eric-handley/a3-srad-camera-kicad/kicad/camera.step

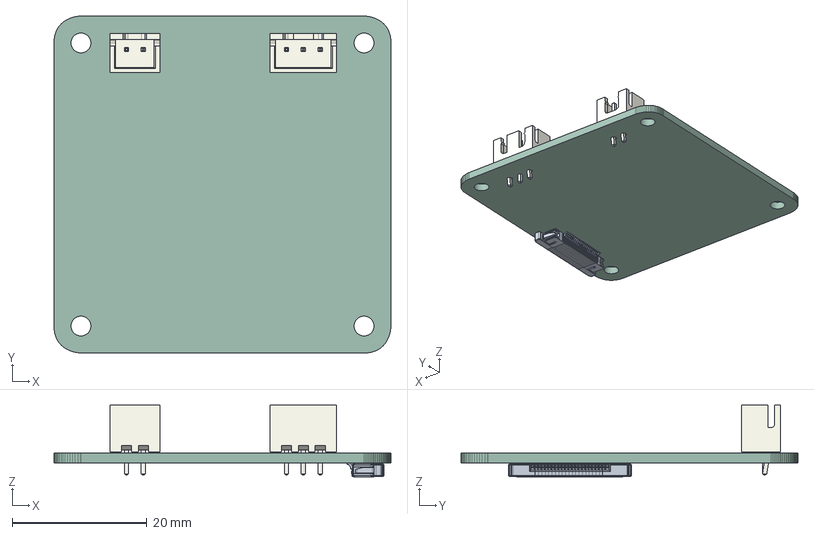
[picture p1: CAD file, 2026-01-13]
kicad/camera.step
50.0 x 50.0 x 10.7 mm
JST_XH_B2B-XH-A_1x02_P2.50mm_Vertical
JST_XH_B3B-XH-A_1x03_P2.50mm_Vertical
F32R_R
F32R_M x 20
F32R_L
srad-camera_PCB
