eric-handley/a3-srad-camera-kicad/kicad/srad-camera-models/RK3566--3DModel-STEP-56544.STEP

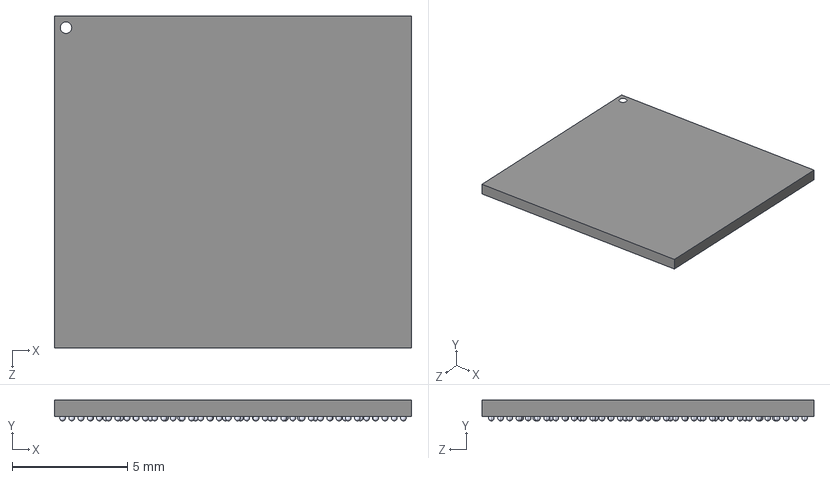
[picture p2: CAD file, 2026-01-15]
kicad/srad-camera-models/RK3566--3DModel-STEP-56544.STEP
15.5 x 0.904 x 14.4 mm
Body^RK3566
ball^RK3566 x 564
