eric-handley/a3-srad-camera-kicad/kicad/srad-camera-models/MT41K256M16TW-107-P--3DModel-STEP-56544.STEP

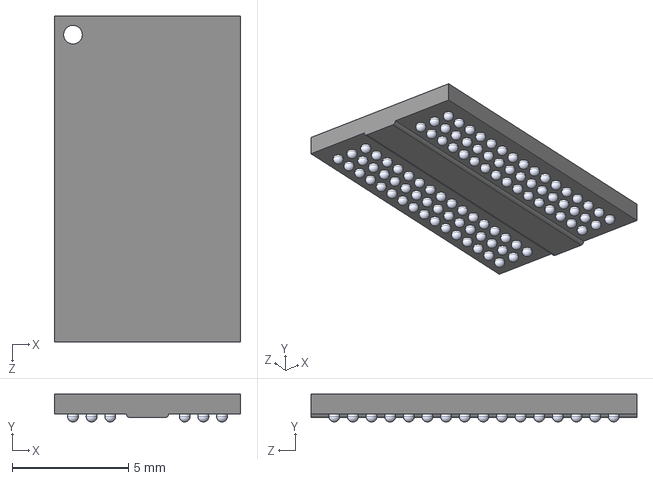
[picture p3: CAD file, 2026-01-15]
kicad/srad-camera-models/MT41K256M16TW-107-P--3DModel-STEP-56544.STEP
8.00 x 1.20 x 14.0 mm
