eric-handley/a3-srad-camera-kicad/kicad/srad-camera-models/0472192001.stp

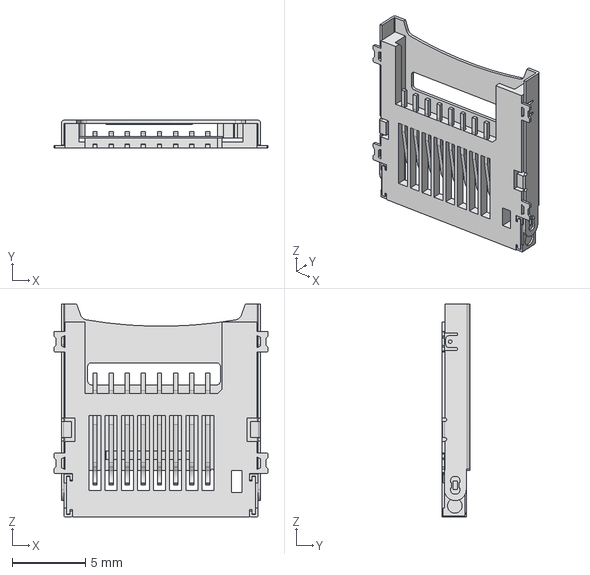
[picture p4: CAD file, 2026-01-15]
kicad/srad-camera-models/0472192001.stp
14.6 x 1.90 x 14.5 mm
