eric-handley/a3-srad-camera-kicad/kicad/srad-camera-models/12402012E212A--3DModel-STEP-533217.STEP

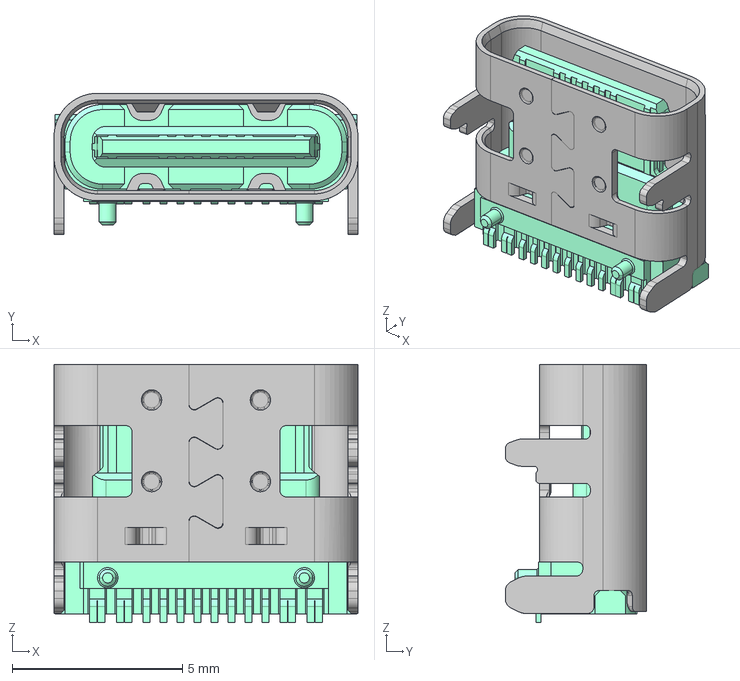
[picture p5: CAD file, 2026-01-15]
kicad/srad-camera-models/12402012E212A--3DModel-STEP-533217.STEP
8.94 x 4.16 x 7.60 mm
