eric-handley/a3-srad-camera-kicad/kicad/srad-camera-models/10051922-2210ELF--3DModel-STEP-533217.STEP

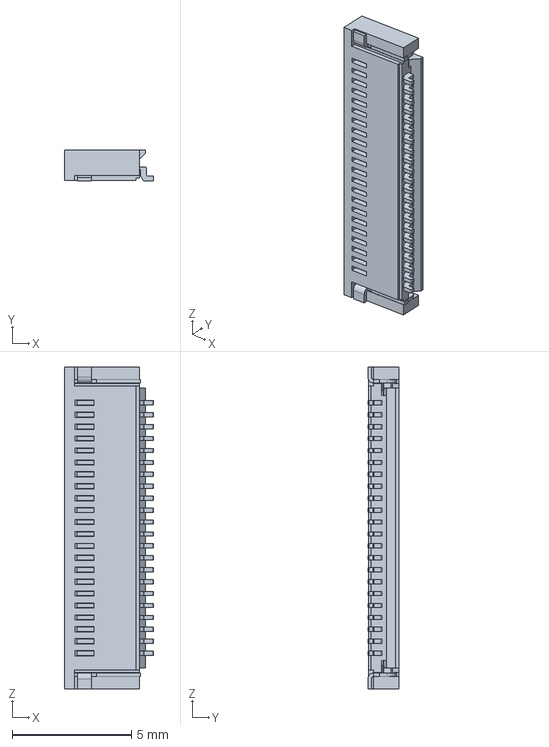
[picture p6: CAD file, 2026-01-15]
kicad/srad-camera-models/10051922-2210ELF--3DModel-STEP-533217.STEP
3.75 x 1.30 x 13.5 mm
