eric-handley/a3-srad-camera-kicad/reference/[rs107]zero 3w_v1.11_20230921 - DDR PHY+wiring.pdf

# RK3566_F(DDR PHY)

## DDR4

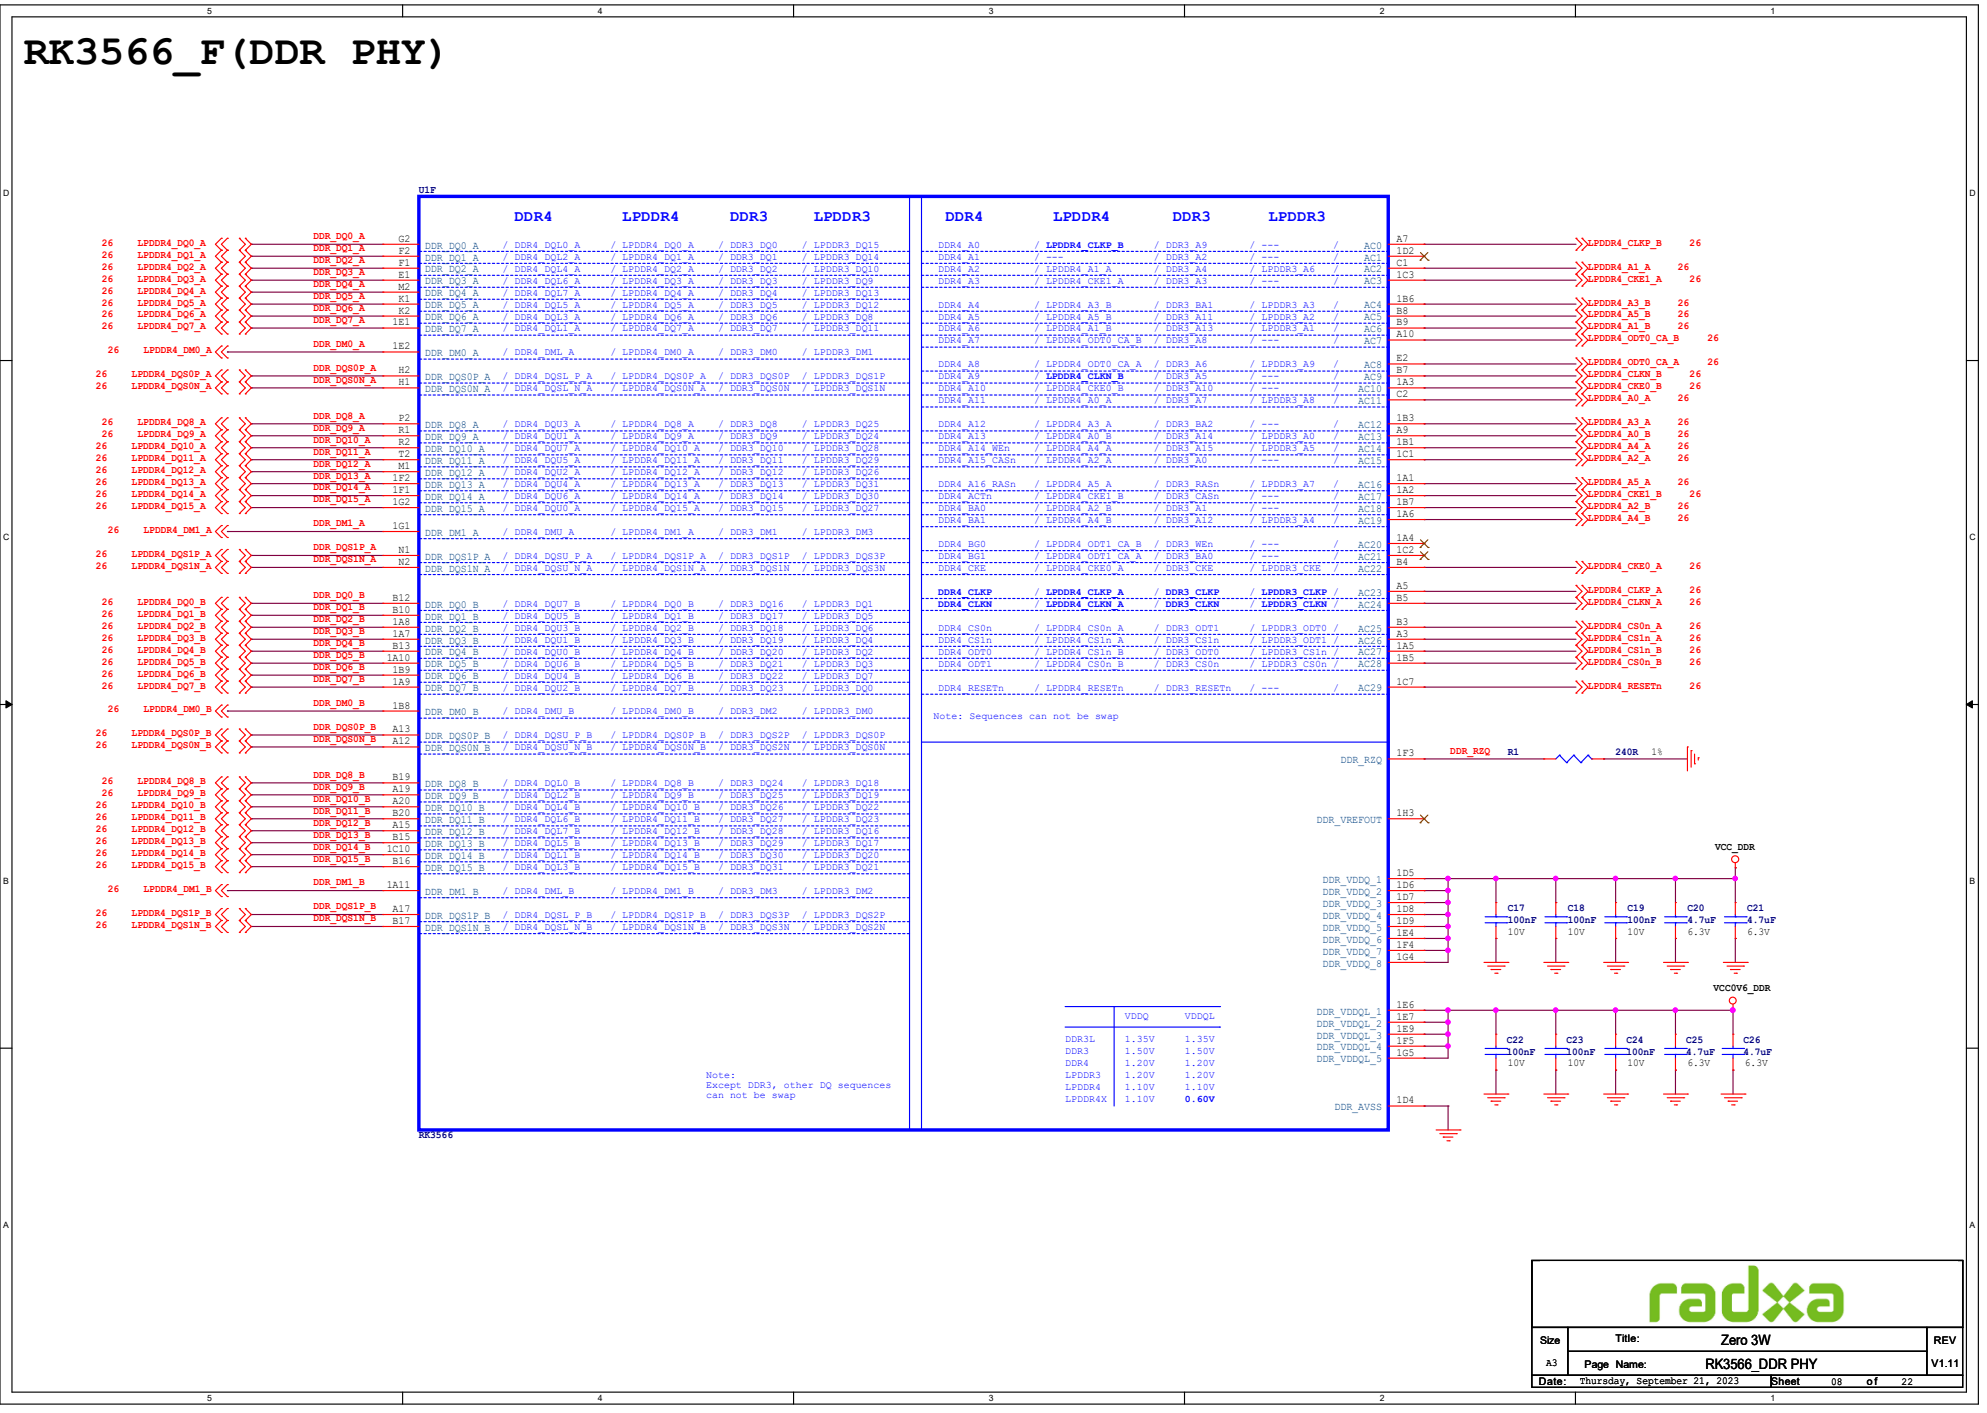
[picture p22: page 1]

Note: Sequences can not be swap

Note:
Except DDR3, other DQ sequences
can not be swap

# CH BCH A

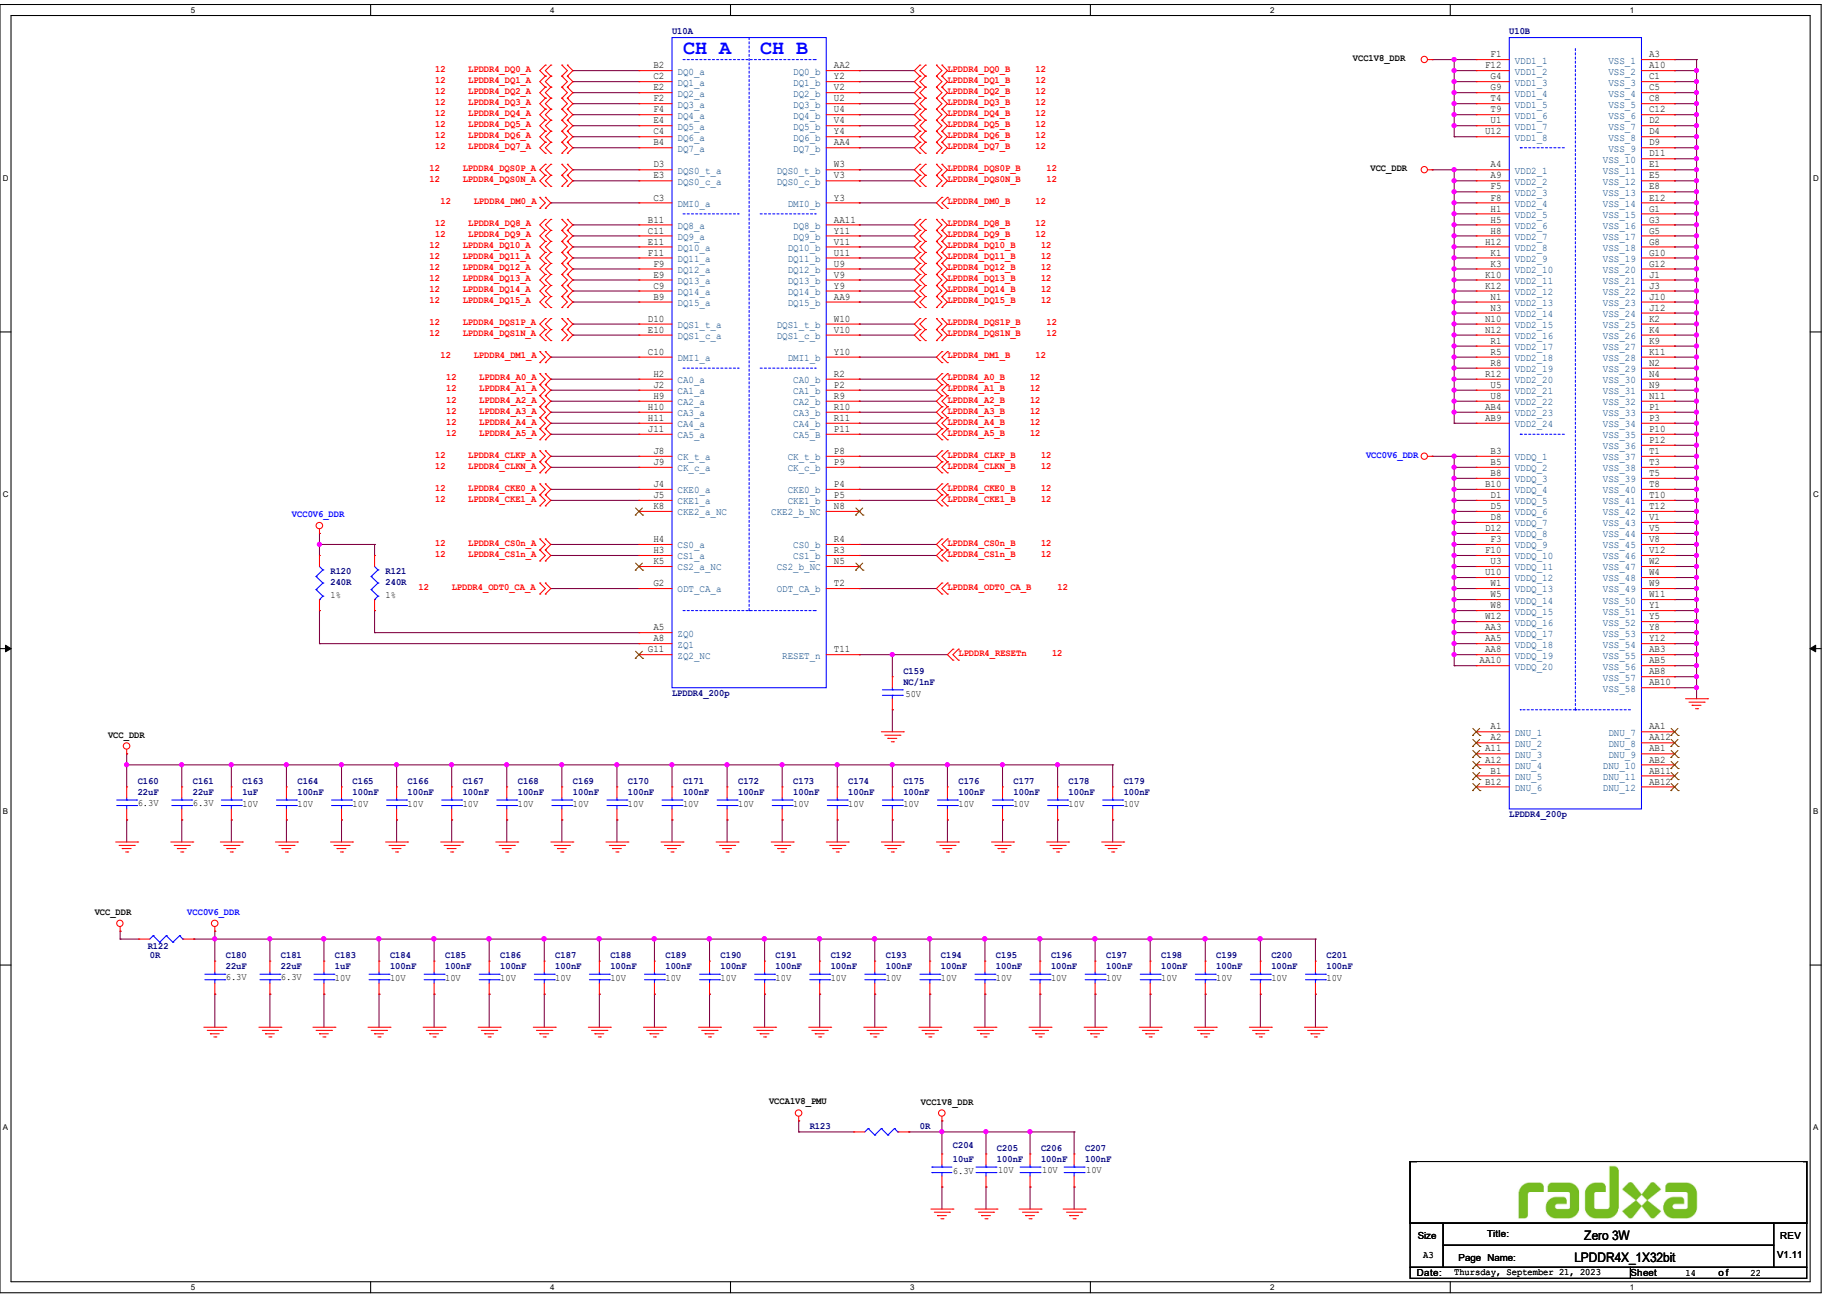
[picture p23: page 2]
