eric-handley/a3-srad-camera-kicad/kicad/srad-camera.kicad_pcb

## KiCad design kicad/srad-camera.kicad_pcb (2026-01-18)

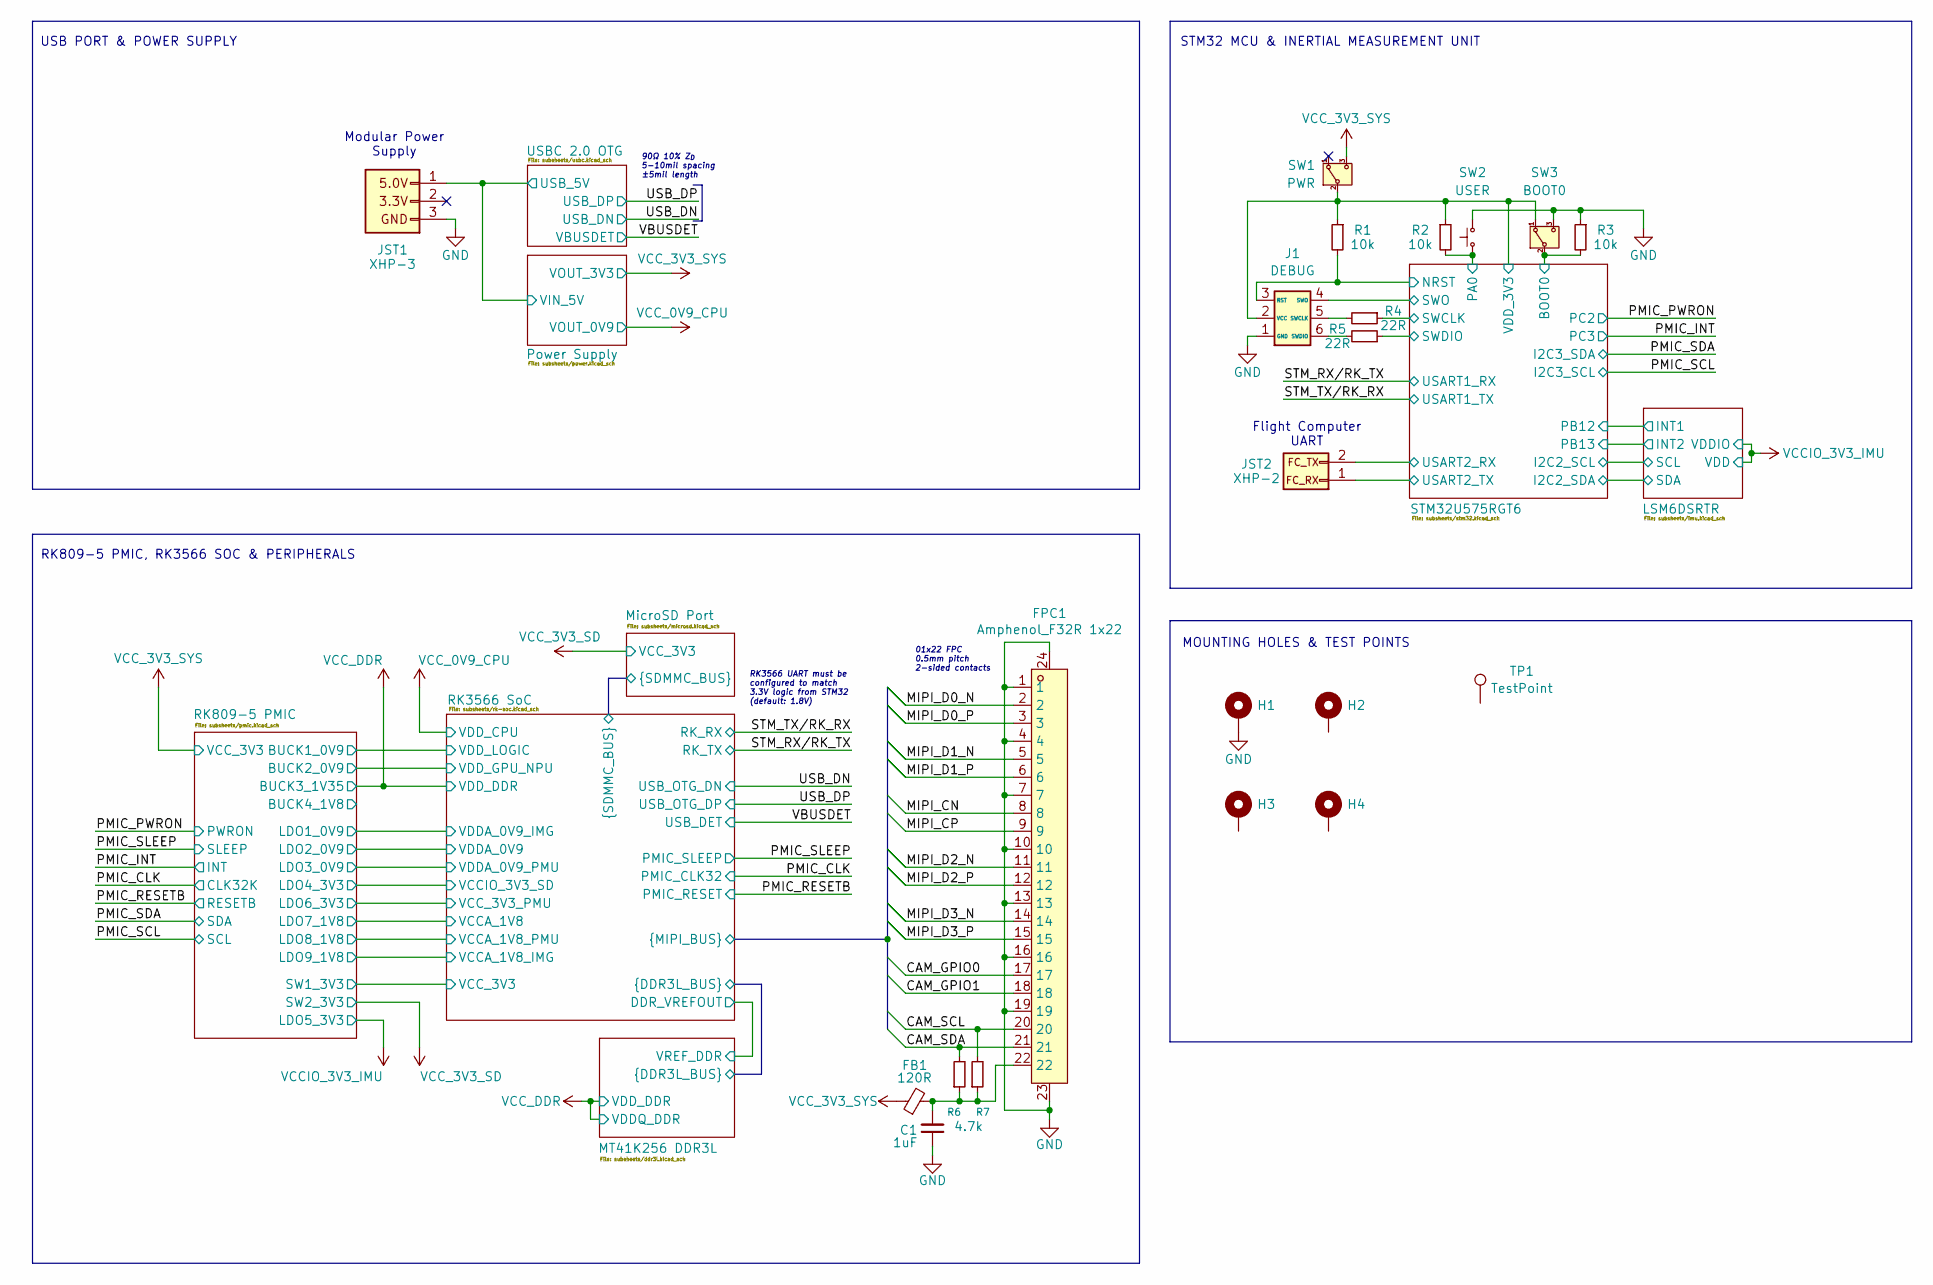
[picture p24: schematic srad-camera.kicad_sch, SRAD Camera]

Parts:
C1: 1uF; C_0603_1608Metric; LCSC PART NAME C15849
FB1: 120R; R_0201_0603Metric; LCSC PART NAME C14709
FPC1: Amphenol_F32R 1x22; AMPHENOL_10051922-2210ELF; MANUFACTURER PART 0.5K-AX-22PWB; JLCPCB PART CLASS Extended Part
H1, H2, H3, H4: MntHole; 4-40_MountingHole
J1: DEBUG; PinHeader_2x03_P1.27mm_Vertical
JST1: XHP-3; JST_XH_B3B-XH-A_1x03_P2.50mm_Vertical
JST2: XHP-2; JST_XH_B2B-XH-A_1x02_P2.50mm_Vertical
R1, R2, R3: 10k; R_0402_1005Metric; LCSC PART NAME C25744
R4, R5: 22R; R_0402_1005Metric; LCSC PART NAME C25092
R6, R7: 4.7k; R_0402_1005Metric; LCSC PART NAME C25900
SW1: PWR; SW_SPDT_PCM12
SW2: USER; SW_SPST_EVQP2_MiddlePushTravel_H2.5mm
SW3: BOOT0; SW_SPDT_PCM12
TP1: TestPoint

Connections:
/Power Supply/VIN_5V: JST1.1; also elsewhere on the board
/RK3566 SoC/CAM_GPIO0: FPC1.17; also elsewhere on the board
/RK3566 SoC/CAM_GPIO1: FPC1.18; also elsewhere on the board
/RK3566 SoC/CAM_SCL: FPC1.20, R7.2; also elsewhere on the board
/RK3566 SoC/CAM_SDA: FPC1.21, R6.2; also elsewhere on the board
/RK3566 SoC/MIPI_CN: FPC1.8; also elsewhere on the board
/RK3566 SoC/MIPI_CP: FPC1.9; also elsewhere on the board
/RK3566 SoC/MIPI_D0_N: FPC1.2; also elsewhere on the board
/RK3566 SoC/MIPI_D0_P: FPC1.3; also elsewhere on the board
/RK3566 SoC/MIPI_D1_N: FPC1.5; also elsewhere on the board
/RK3566 SoC/MIPI_D1_P: FPC1.6; also elsewhere on the board
/RK3566 SoC/MIPI_D2_N: FPC1.11; also elsewhere on the board
/RK3566 SoC/MIPI_D2_P: FPC1.12; also elsewhere on the board
/RK3566 SoC/MIPI_D3_N: FPC1.14; also elsewhere on the board
/RK3566 SoC/MIPI_D3_P: FPC1.15; also elsewhere on the board
/STM32U575RGT6/BOOT0: R3.2, SW3.2 (B); also elsewhere on the board
/STM32U575RGT6/NRST: J1.3 (RST), R1.2; also elsewhere on the board
/STM32U575RGT6/PA0: R2.2, SW2.1; also elsewhere on the board
/STM32U575RGT6/SWCLK: R4.1; also elsewhere on the board
/STM32U575RGT6/SWDIO: R5.1; also elsewhere on the board
/STM32U575RGT6/SWO: J1.4 (SWO); also elsewhere on the board
/STM32U575RGT6/USART2_RX: JST2.2; also elsewhere on the board
/STM32U575RGT6/USART2_TX: JST2.1; also elsewhere on the board
/STM32U575RGT6/VDD_3V3: J1.2 (VCC), R1.1, R2.1, SW1.2 (B), SW3.1 (A); also elsewhere on the board
GND: C1.1, FPC1.1, FPC1.4, FPC1.7, FPC1.10, FPC1.13, FPC1.16, FPC1.19, FPC1.23, FPC1.24, H1.1 (MP), J1.1 (GND), JST1.3, R3.1, SW2.2, SW3.3 (C); also elsewhere on the board
unnamed: C1.2, FB1.2, FPC1.22, R6.1, R7.1
unnamed: J1.5 (SWCLK), R4.2
unnamed: J1.6 (SWDIO), R5.2
VCC_3V3_SYS: FB1.1, SW1.3 (C); also elsewhere on the board

Notes on the sheet:
STM32 MCU & INERTIAL MEASUREMENT UNIT
USB PORT & POWER SUPPLY
01x22 FPC 0.5mm pitch 2-sided contacts
90Ω 10% Z_{D} 5-10mil spacing ±5mil length
RK3566 UART must be configured to match 3.3V logic from STM32 (default: 1.8V)
RK809-5 PMIC, RK3566 SOC & PERIPHERALS
Modular Power Supply
Flight Computer UART
MOUNTING HOLES & TEST POINTS

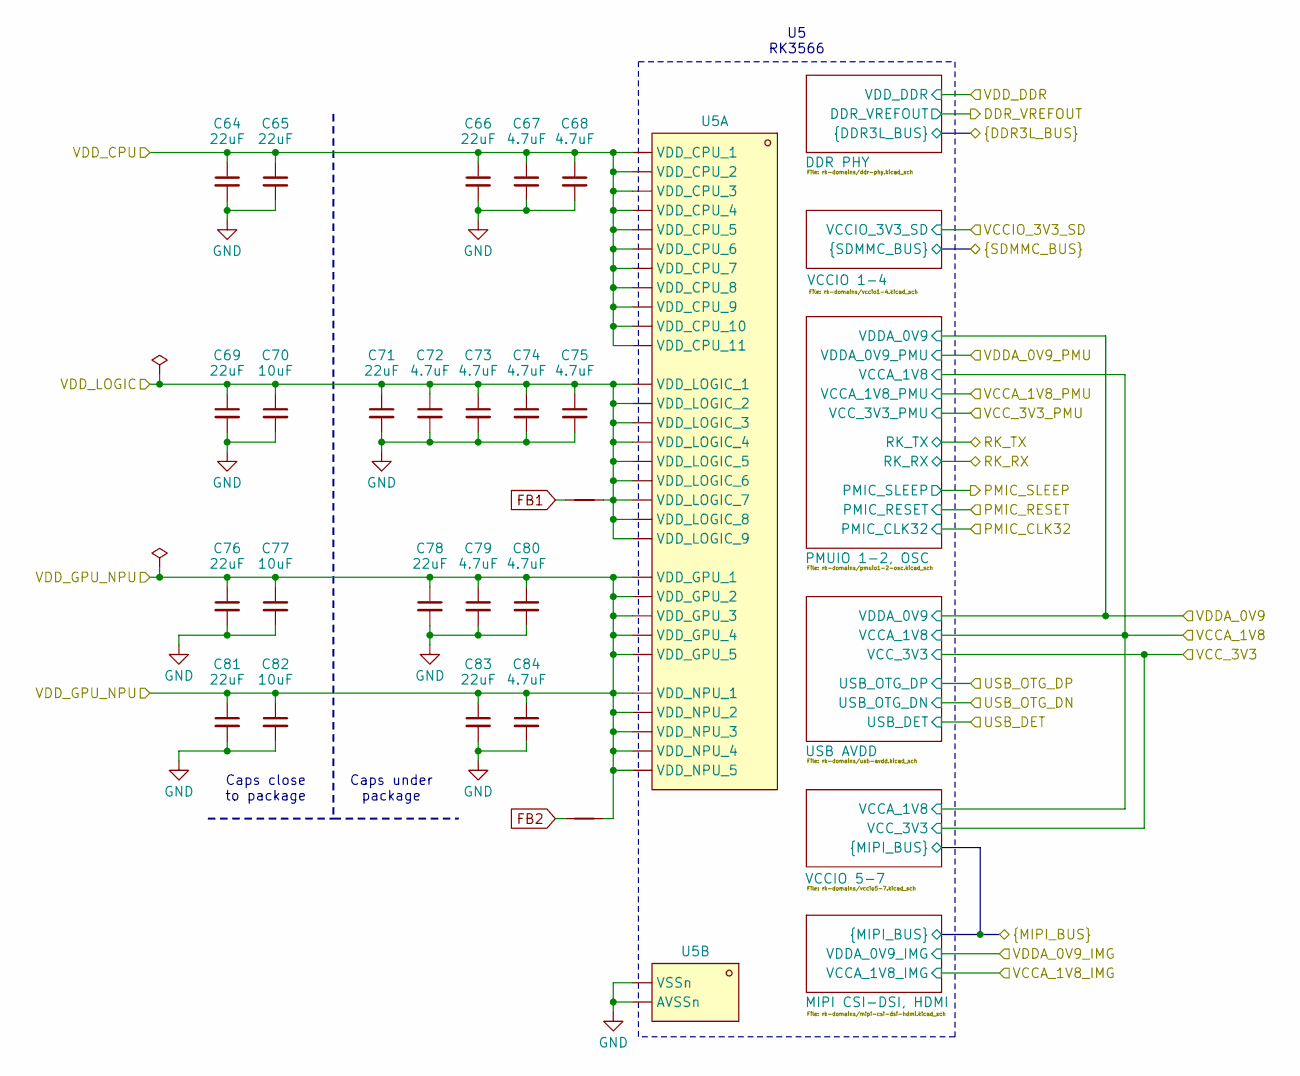
[picture p25: schematic rk-soc.kicad_sch, RK3566 SoC]

Parts:
C64, C65, C66, C69, C71, C76, C78, C81, C83: 22uF; C_1206_3216Metric; LCSC PART NAME C12891
C67, C68, C72, C73, C74, C75, C79, C80, C84: 4.7uF; C_0402_1005Metric; LCSC PART NAME C1779
C70, C77, C82: 10uF; C_0805_2012Metric; LCSC PART NAME C15850
NT3, NT4: NetTie_2
U5: RK3566; BGA-565_L15.5-W14.4-P0.40_RK3566_1; MANUFACTURER PART RK3566; JLCPCB PART CLASS Extended Part

Connections:
/RK3566 SoC/VDD_GPU_NPU: C76.1, C77.1, C78.1, C79.1, C80.1, C81.1, C82.1, C83.1, C84.1, NT4.2, U5.1G15 (VDD_NPU_1), U5.1H14 (VDD_NPU_2), U5.1H15 (VDD_NPU_3), U5.1J14 (VDD_NPU_4), U5.1J15 (VDD_NPU_5), U5.1L8 (VDD_GPU_1), U5.1L9 (VDD_GPU_2), U5.1M7 (VDD_GPU_3), U5.1M8 (VDD_GPU_4), U5.1M9 (VDD_GPU_5); also elsewhere on the board
/RK3566 SoC/VDD_LOGIC: C69.1, C70.1, C71.1, C72.1, C73.1, C74.1, C75.1, NT3.2, U5.1H7 (VDD_LOGIC_1), U5.1H8 (VDD_LOGIC_2), U5.1H9 (VDD_LOGIC_3), U5.1H10 (VDD_LOGIC_4), U5.1J7 (VDD_LOGIC_5), U5.1J10 (VDD_LOGIC_6), U5.1K7 (VDD_LOGIC_7), U5.1K10 (VDD_LOGIC_8), U5.1L7 (VDD_LOGIC_9); also elsewhere on the board
GND: C64.2, C65.2, C66.2, C67.2, C68.2, C69.2, C70.2, C71.2, C72.2, C73.2, C74.2, C75.2, C76.2, C77.2, C78.2, C79.2, C80.2, C81.2, C82.2, C83.2, C84.2, U5.1B10 (VSS_30), U5.1B11 (VSS_31), U5.1B15 (VSS_32), U5.1B19 (VSS_33), U5.1C4 (VSS_34), U5.1C5 (VSS_35), U5.1C6 (VSS_36), U5.1C8 (VSS_37), U5.1C9 (VSS_38), U5.1C14 (VSS_39), U5.1C16 (VSS_40), U5.1C18 (VSS_41), U5.1D1 (VSS_42), U5.1D3 (VSS_43), U5.1D10 (VSS_44), U5.1D14 (VSS_45), U5.1E3 (VSS_46), U5.1E8 (VSS_47), U5.1E10 (VSS_48), U5.1E14 (VSS_49), U5.1E15 (VSS_50), U5.1E17 (VSS_51), U5.1F6 (VSS_52), U5.1F7 (VSS_53), U5.1F8 (VSS_54), U5.1F9 (VSS_55), U5.1F10 (VSS_56), U5.1F15 (VSS_57), U5.1F16 (VSS_58), U5.1F20 (AVSS1_6), U5.1G3 (VSS_59), U5.1G6 (VSS_60), U5.1G7 (VSS_61), U5.1G8 (VSS_62), U5.1G9 (VSS_63), U5.1G10 (VSS_64), U5.1G11 (VSS_65), U5.1G12 (VSS_66), U5.1G14 (VSS_67), U5.1G16 (AVSS1_7), U5.1G18 (AVSS1_8), U5.1G19 (AVSS1_9), U5.1G20 (AVSS1_10), U5.1H1 (VSS_68), U5.1H2 (VSS_69), U5.1H6 (VSS_70), U5.1H11 (VSS_71), U5.1H12 (VSS_72), U5.1H13 (VSS_73), U5.1J1 (VSS_74), U5.1J6 (VSS_75), U5.1J8 (VSS_76), U5.1J9 (VSS_77), U5.1J11 (VSS_78), U5.1J12 (VSS_79), U5.1J13 (VSS_80), U5.1J16 (AVSS1_11), U5.1J18 (AVSS1_12), U5.1K2 (VSS_81), U5.1K3 (VSS_82), U5.1K4 (VSS_83), U5.1K5 (VSS_84), U5.1K6 (VSS_85), U5.1K8 (VSS_86), U5.1K9 (VSS_87), U5.1K11 (VSS_88), U5.1K12 (VSS_89), U5.1K13 (VSS_90), U5.1K14 (VSS_91), U5.1K15 (VSS_92), U5.1K18 (AVSS1_13), U5.1L3 (VSS_93), U5.1L6 (VSS_94), U5.1L10 (VSS_95), U5.1L11 (VSS_96), U5.1L12 (VSS_97), U5.1L13 (VSS_98), U5.1L14 (VSS_99), U5.1L15 (VSS_100), U5.1L19 (AVSS1_14), U5.1M3 (VSS_101), U5.1M4 (VSS_102), U5.1M5 (VSS_103), U5.1M6 (VSS_104), U5.1M10 (VSS_105), U5.1M11 (VSS_106), U5.1M12 (VSS_107), U5.1M13 (VSS_108), U5.1M14 (VSS_109), U5.1M15 (VSS_110), U5.1M16 (VSS_111), U5.1M17 (VSS_112), U5.1M20 (VSS_113), U5.1N3 (VSS_114), U5.1N4 (VSS_115), U5.1N7 (VSS_116), U5.1N11 (AVSS_9), U5.1N12 (AVSS_10), U5.1P1 (VSS_117), U5.1P5 (VSS_118), U5.1P6 (VSS_119), U5.1P7 (VSS_120), U5.1P8 (AVSS_11), U5.1P10 (AVSS_12), U5.1P14 (AVSS_13), U5.1P15 (VSS_121), U5.1R3 (VSS_122), U5.1R4 (VSS_123), U5.1R5 (VSS_124), U5.1R6 (VSS_125), U5.1R7 (VSS_126), U5.1R8 (AVSS_14), U5.1R9 (AVSS_15), U5.1R11 (AVSS_16), U5.1R12 (AVSS_17), U5.1R13 (AVSS_18), U5.1R14 (AVSS_19), U5.1R15 (AVSS_20), U5.1T3 (VSS_127), U5.1T5 (VSS_128), U5.1T7 (AVSS_21), U5.1T8 (AVSS_22), U5.1T9 (AVSS_23), U5.1T10 (AVSS_24), U5.1T11 (AVSS_25), U5.1T12 (AVSS_26), U5.1T13 (AVSS_27), U5.1T14 (AVSS_28), U5.1T15 (AVSS_29), U5.1T16 (AVSS_30), U5.1T17 (AVSS_31), U5.1U2 (VSS_129), U5.1U12 (AVSS_32), U5.1U13 (AVSS_33), U5.1U15 (AVSS_34), U5.1U17 (AVSS_35), U5.1V1 (VSS_130), U5.1V4 (VSS_131), U5.1V7 (AVSS_36), U5.1V12 (AVSS_37), U5.1V13 (AVSS_38), U5.1V18 (AVSS_39), U5.A1 (VSSn), U5.A2 (VSS_2), U5.A38 (VSS_3), U5.AA2 (VSS_18), U5.AC37 (VSS_24), U5.AD2 (VSS_19), U5.AE37 (VSS_25), U5.AH37 (VSS_26), U5.AL37 (VSS_27), U5.AP2 (VSS_20), U5.AP8 (VSS_22), U5.AP13 (AVSS_1), U5.AP16 (AVSS_2), U5.AP19 (AVSS_3), U5.AP22 (AVSS_4), U5.AP25 (AVSS_5), U5.AP28 (AVSS_6), U5.AP31 (AVSS_7), U5.AP34 (AVSS_8), U5.AP37 (VSS_28), U5.AR1 (VSS_21), U5.AR38 (VSS_29), U5.B1 (VSS_4), U5.B2 (VSS_5), U5.B6 (VSS_6), U5.B11 (VSS_7), U5.B14 (VSS_8), U5.B18 (VSS_9), U5.B21 (VSS_10), U5.B28 (VSS_11), U5.B31 (VSS_12), U5.D2 (VSS_13), U5.E37 (VSS_23), U5.H37 (AVSSn), U5.J2 (VSS_14), U5.L2 (VSS_15), U5.L37 (AVSS1_2), U5.P37 (AVSS1_3), U5.U2 (VSS_16), U5.U37 (AVSS1_4), U5.W2 (VSS_17), U5.Y37 (AVSS1_5); also elsewhere on the board
VCC_0V9_CPU: C64.1, C65.1, C66.1, C67.1, C68.1, U5.1C12 (VDD_CPU_1), U5.1D11 (VDD_CPU_2), U5.1D12 (VDD_CPU_3), U5.1E11 (VDD_CPU_4), U5.1E12 (VDD_CPU_5), U5.1E13 (VDD_CPU_6), U5.1F11 (VDD_CPU_7), U5.1F12 (VDD_CPU_8), U5.1F13 (VDD_CPU_9), U5.1F14 (VDD_CPU_10), U5.1G13 (VDD_CPU_11); also elsewhere on the board

Notes on the sheet:
U5 RK3566
Caps close to package
Caps under package

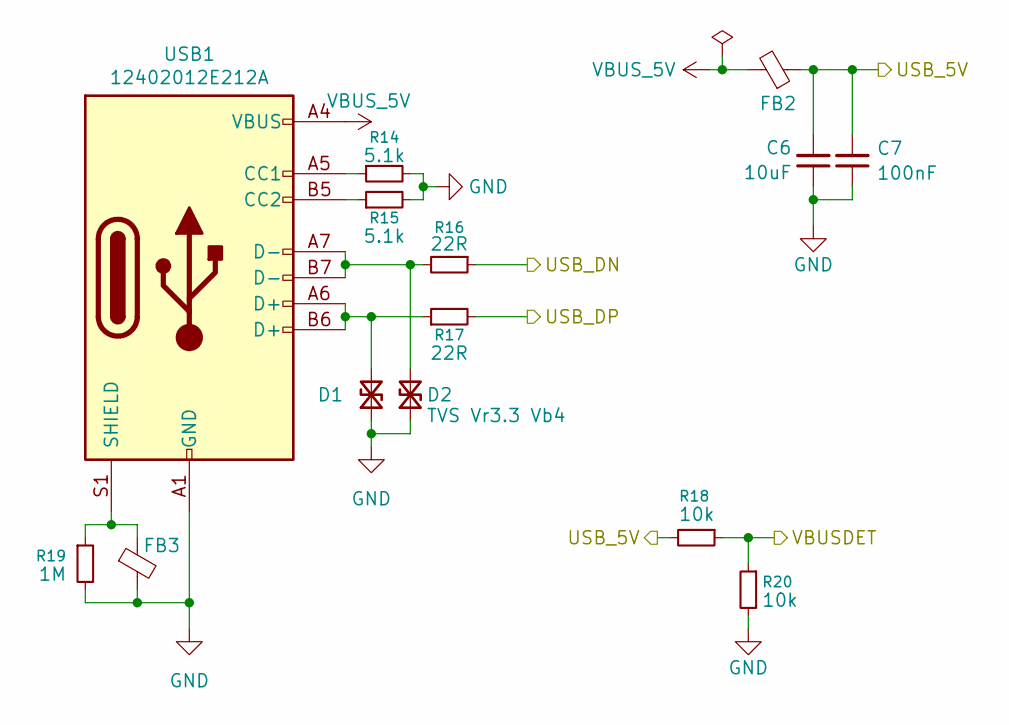
[picture p26: schematic usbc.kicad_sch, USB C Port]

Parts:
C6: 10uF; C_0805_2012Metric; LCSC PART NAME C15850
C7: 100nF; C_0402_1005Metric; LCSC PART NAME C1525
D1, D2: TVS Vr3.3 Vb4; D_SOD-123F; LCSC PART NAME C19077496
FB2, FB3: 120R; R_0201_0603Metric; LCSC PART NAME C14709
R14, R15: 5.1k; R_0402_1005Metric; LCSC PART NAME C25905
R16, R17: 22R; R_0402_1005Metric; LCSC PART NAME C25092
R18, R20: 10k; R_0402_1005Metric; LCSC PART NAME C25744
R19: 1M; R_0402_1005Metric; LCSC PART NAME C26083
USB1: 12402012E212A; USB_C_Receptacle_HRO_TYPE-C-31-M-12

Connections:
/Power Supply/VIN_5V: C6.2, C7.2, FB2.1, R18.2; also elsewhere on the board
/USB_DN: R16.1; also elsewhere on the board
/USB_DP: R17.2; also elsewhere on the board
/VBUSDET: R18.1, R20.1; also elsewhere on the board
GND: C6.1, C7.1, D1.1 (A1), D2.1 (A1), FB3.2, R14.2, R15.2, R19.2, R20.2, USB1.A1 (GND), USB1.A12 (GND), USB1.B1 (GND), USB1.B12 (GND); also elsewhere on the board
unnamed: D1.2 (A2), R17.1, USB1.A6 (D+), USB1.B6 (D+)
unnamed: D2.2 (A2), R16.2, USB1.A7 (D-), USB1.B7 (D-)
unnamed: R14.1, USB1.A5 (CC1)
unnamed: R15.1, USB1.B5 (CC2)
unnamed: FB3.1, R19.1, USB1.S1 (SHIELD)
VBUS_5V: FB2.2, USB1.A4 (VBUS), USB1.A9 (VBUS), USB1.B4 (VBUS), USB1.B9 (VBUS)

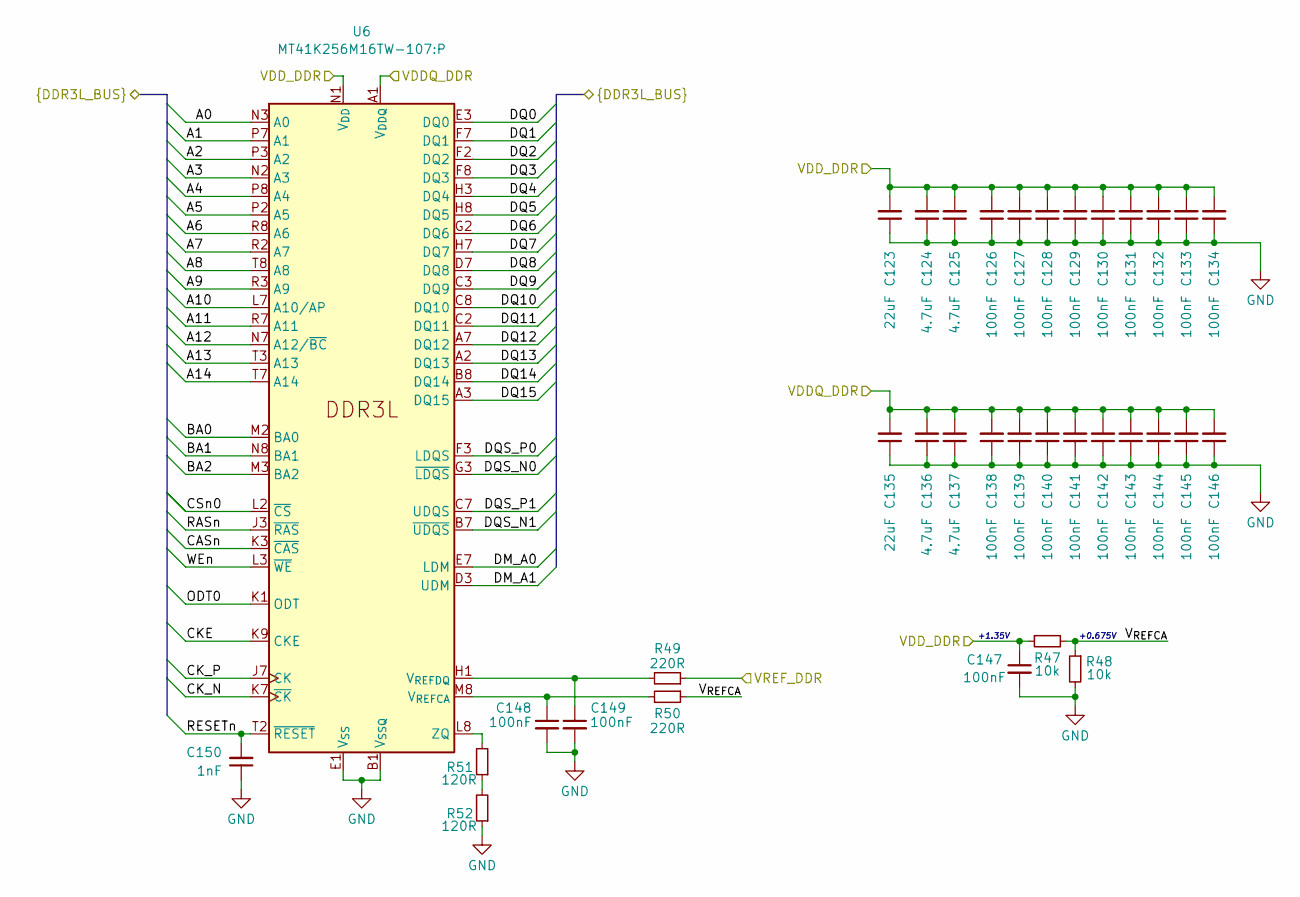
[picture p27: schematic ddr3l.kicad_sch, DDR3L Memory]

Parts:
C123, C135: 22uF; C_1206_3216Metric; LCSC PART NAME C12891
C124, C125, C136, C137: 4.7uF; C_0805_2012Metric; LCSC PART NAME C1779
C126, C127, C128, C129, C130, C131, C132, C133, C134, C138, C139, C140, C141, C142, C143, C144, C145, C146, C147, C148, C149: 100nF; C_0402_1005Metric; LCSC PART NAME C1525
C150: 1nF; C_0402_1005Metric; LCSC PART NAME C1523
R47, R48: 10k; R_0603_1608Metric; LCSC PART NAME C25804
R49, R50: 220R; R_0603_1608Metric; LCSC PART NAME C22962
R51, R52: 120R; R_0402_1005Metric; LCSC PART NAME C25079
U6: MT41K256M16TW-107:P; Micron_FBGA-96_8x14mm_Layout9x16_P0.8mm

Connections:
/MT41K256 DDR3L/A0: U6.N3 (A0); also elsewhere on the board
/MT41K256 DDR3L/A1: U6.P7 (A1); also elsewhere on the board
/MT41K256 DDR3L/A2: U6.P3 (A2); also elsewhere on the board
/MT41K256 DDR3L/A3: U6.N2 (A3); also elsewhere on the board
/MT41K256 DDR3L/A4: U6.P8 (A4); also elsewhere on the board
/MT41K256 DDR3L/A5: U6.P2 (A5); also elsewhere on the board
/MT41K256 DDR3L/A6: U6.R8 (A6); also elsewhere on the board
/MT41K256 DDR3L/A7: U6.R2 (A7); also elsewhere on the board
/MT41K256 DDR3L/A8: U6.T8 (A8); also elsewhere on the board
/MT41K256 DDR3L/A9: U6.R3 (A9); also elsewhere on the board
/MT41K256 DDR3L/A10: U6.L7 (A10/AP); also elsewhere on the board
/MT41K256 DDR3L/A11: U6.R7 (A11); also elsewhere on the board
/MT41K256 DDR3L/A12: U6.N7 (A12/~BC); also elsewhere on the board
/MT41K256 DDR3L/A13: U6.T3 (A13); also elsewhere on the board
/MT41K256 DDR3L/A14: U6.T7 (A14); also elsewhere on the board
/MT41K256 DDR3L/BA0: U6.M2 (BA0); also elsewhere on the board
/MT41K256 DDR3L/BA1: U6.N8 (BA1); also elsewhere on the board
/MT41K256 DDR3L/BA2: U6.M3 (BA2); also elsewhere on the board
/MT41K256 DDR3L/CASn: U6.K3 (~CAS); also elsewhere on the board
/MT41K256 DDR3L/CKE: U6.K9 (CKE); also elsewhere on the board
/MT41K256 DDR3L/CK_N: U6.K7 (~CK); also elsewhere on the board
/MT41K256 DDR3L/CK_P: U6.J7 (CK); also elsewhere on the board
/MT41K256 DDR3L/CSn0: U6.L2 (~CS); also elsewhere on the board
/MT41K256 DDR3L/DM_A0: U6.E7 (LDM); also elsewhere on the board
/MT41K256 DDR3L/DM_A1: U6.D3 (UDM); also elsewhere on the board
/MT41K256 DDR3L/DQ0: U6.E3 (DQ0); also elsewhere on the board
/MT41K256 DDR3L/DQ1: U6.F7 (DQ1); also elsewhere on the board
/MT41K256 DDR3L/DQ2: U6.F2 (DQ2); also elsewhere on the board
/MT41K256 DDR3L/DQ3: U6.F8 (DQ3); also elsewhere on the board
/MT41K256 DDR3L/DQ4: U6.H3 (DQ4); also elsewhere on the board
/MT41K256 DDR3L/DQ5: U6.H8 (DQ5); also elsewhere on the board
/MT41K256 DDR3L/DQ6: U6.G2 (DQ6); also elsewhere on the board
/MT41K256 DDR3L/DQ7: U6.H7 (DQ7); also elsewhere on the board
/MT41K256 DDR3L/DQ8: U6.D7 (DQ8); also elsewhere on the board
/MT41K256 DDR3L/DQ9: U6.C3 (DQ9); also elsewhere on the board
/MT41K256 DDR3L/DQ10: U6.C8 (DQ10); also elsewhere on the board
/MT41K256 DDR3L/DQ11: U6.C2 (DQ11); also elsewhere on the board
/MT41K256 DDR3L/DQ12: U6.A7 (DQ12); also elsewhere on the board
/MT41K256 DDR3L/DQ13: U6.A2 (DQ13); also elsewhere on the board
/MT41K256 DDR3L/DQ14: U6.B8 (DQ14); also elsewhere on the board
/MT41K256 DDR3L/DQ15: U6.A3 (DQ15); also elsewhere on the board
/MT41K256 DDR3L/DQS_N0: U6.G3 (~LDQS); also elsewhere on the board
/MT41K256 DDR3L/DQS_N1: U6.B7 (~UDQS); also elsewhere on the board
/MT41K256 DDR3L/DQS_P0: U6.F3 (LDQS); also elsewhere on the board
/MT41K256 DDR3L/DQS_P1: U6.C7 (UDQS); also elsewhere on the board
/MT41K256 DDR3L/ODT0: U6.K1 (ODT); also elsewhere on the board
/MT41K256 DDR3L/RASn: U6.J3 (~RAS); also elsewhere on the board
/MT41K256 DDR3L/RESETn: C150.2, U6.T2 (~RESET); also elsewhere on the board
/MT41K256 DDR3L/VREF_DDR: R49.1; also elsewhere on the board
/MT41K256 DDR3L/V_{REFCA}: R47.2, R48.1, R50.1
/MT41K256 DDR3L/WEn: U6.L3 (~WE); also elsewhere on the board
GND: C123.1, C124.1, C125.1, C126.1, C127.1, C128.1, C129.1, C130.1, C131.1, C132.1, C133.1, C134.1, C135.1, C136.1, C137.1, C138.1, C139.1, C140.1, C141.1, C142.1, C143.1, C144.1, C145.1, C146.1, C147.2, C148.2, C149.2, C150.1, R48.2, R52.1, U6.A9 (V_{SS}), U6.B1 (V_{SSQ}), U6.B3 (V_{SS}), U6.B9 (V_{SSQ}), U6.D1 (V_{SSQ}), U6.D8 (V_{SSQ}), U6.E1 (V_{SS}), U6.E2 (V_{SSQ}), U6.E8 (V_{SSQ}), U6.F9 (V_{SSQ}), U6.G1 (V_{SSQ}), U6.G8 (V_{SS}), U6.G9 (V_{SSQ}), U6.J2 (V_{SS}), U6.J8 (V_{SS}), U6.M1 (V_{SS}), U6.M9 (V_{SS}), U6.P1 (V_{SS}), U6.P9 (V_{SS}), U6.T1 (V_{SS}), U6.T9 (V_{SS}); also elsewhere on the board
unnamed: R51.1, R52.2
unnamed: C148.1, R50.2, U6.M8 (V_{REFCA})
unnamed: C149.1, R49.2, U6.H1 (V_{REFDQ})
unnamed: R51.2, U6.L8 (ZQ)
VCC_DDR: C123.2, C124.2, C125.2, C126.2, C127.2, C128.2, C129.2, C130.2, C131.2, C132.2, C133.2, C134.2, C135.2, C136.2, C137.2, C138.2, C139.2, C140.2, C141.2, C142.2, C143.2, C144.2, C145.2, C146.2, C147.1, R47.1, U6.A1 (V_{DDQ}), U6.A8 (V_{DDQ}), U6.B2 (V_{DD}), U6.C1 (V_{DDQ}), U6.C9 (V_{DDQ}), U6.D2 (V_{DDQ}), U6.D9 (V_{DD}), U6.E9 (V_{DDQ}), U6.F1 (V_{DDQ}), U6.G7 (V_{DD}), U6.H2 (V_{DDQ}), U6.H9 (V_{DDQ}), U6.K2 (V_{DD}), U6.K8 (V_{DD}), U6.N1 (V_{DD}), U6.N9 (V_{DD}), U6.R1 (V_{DD}), U6.R9 (V_{DD}); also elsewhere on the board

Notes on the sheet:
+1.35V
+0.675V

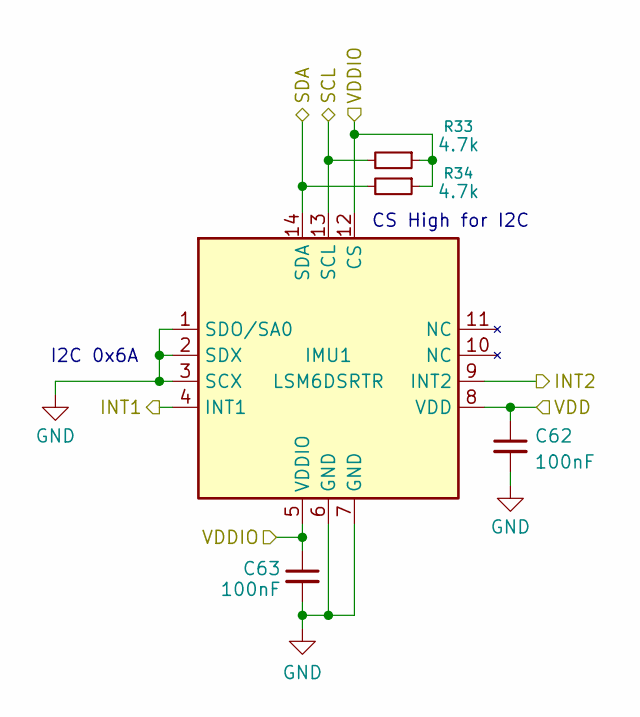
[picture p28: schematic imu.kicad_sch, Inertial Measurement Unit]

Parts:
C62, C63: 100nF; C_0402_1005Metric; LCSC PART NAME C1525
IMU1: LSM6DSRTR; LGA-14_3x2.5mm_P0.5mm_LayoutBorder3x4y
R33, R34: 4.7k; R_0402_1005Metric; LCSC PART NAME C25900

Connections:
/LSM6DSRTR/INT1: IMU1.4 (INT1); also elsewhere on the board
/LSM6DSRTR/INT2: IMU1.9 (INT2); also elsewhere on the board
/LSM6DSRTR/SCL: IMU1.13 (SCL), R33.2; also elsewhere on the board
/LSM6DSRTR/SDA: IMU1.14 (SDA), R34.2; also elsewhere on the board
GND: C62.2, C63.2, IMU1.1 (SDO/SA0), IMU1.2 (SDX), IMU1.3 (SCX), IMU1.6 (GND), IMU1.7 (GND); also elsewhere on the board
VCCIO_3V3_IMU: C62.1, C63.1, IMU1.5 (VDDIO), IMU1.8 (VDD), IMU1.12 (CS), R33.1, R34.1; also elsewhere on the board

Notes on the sheet:
CS High for I2C
I2C 0x6A

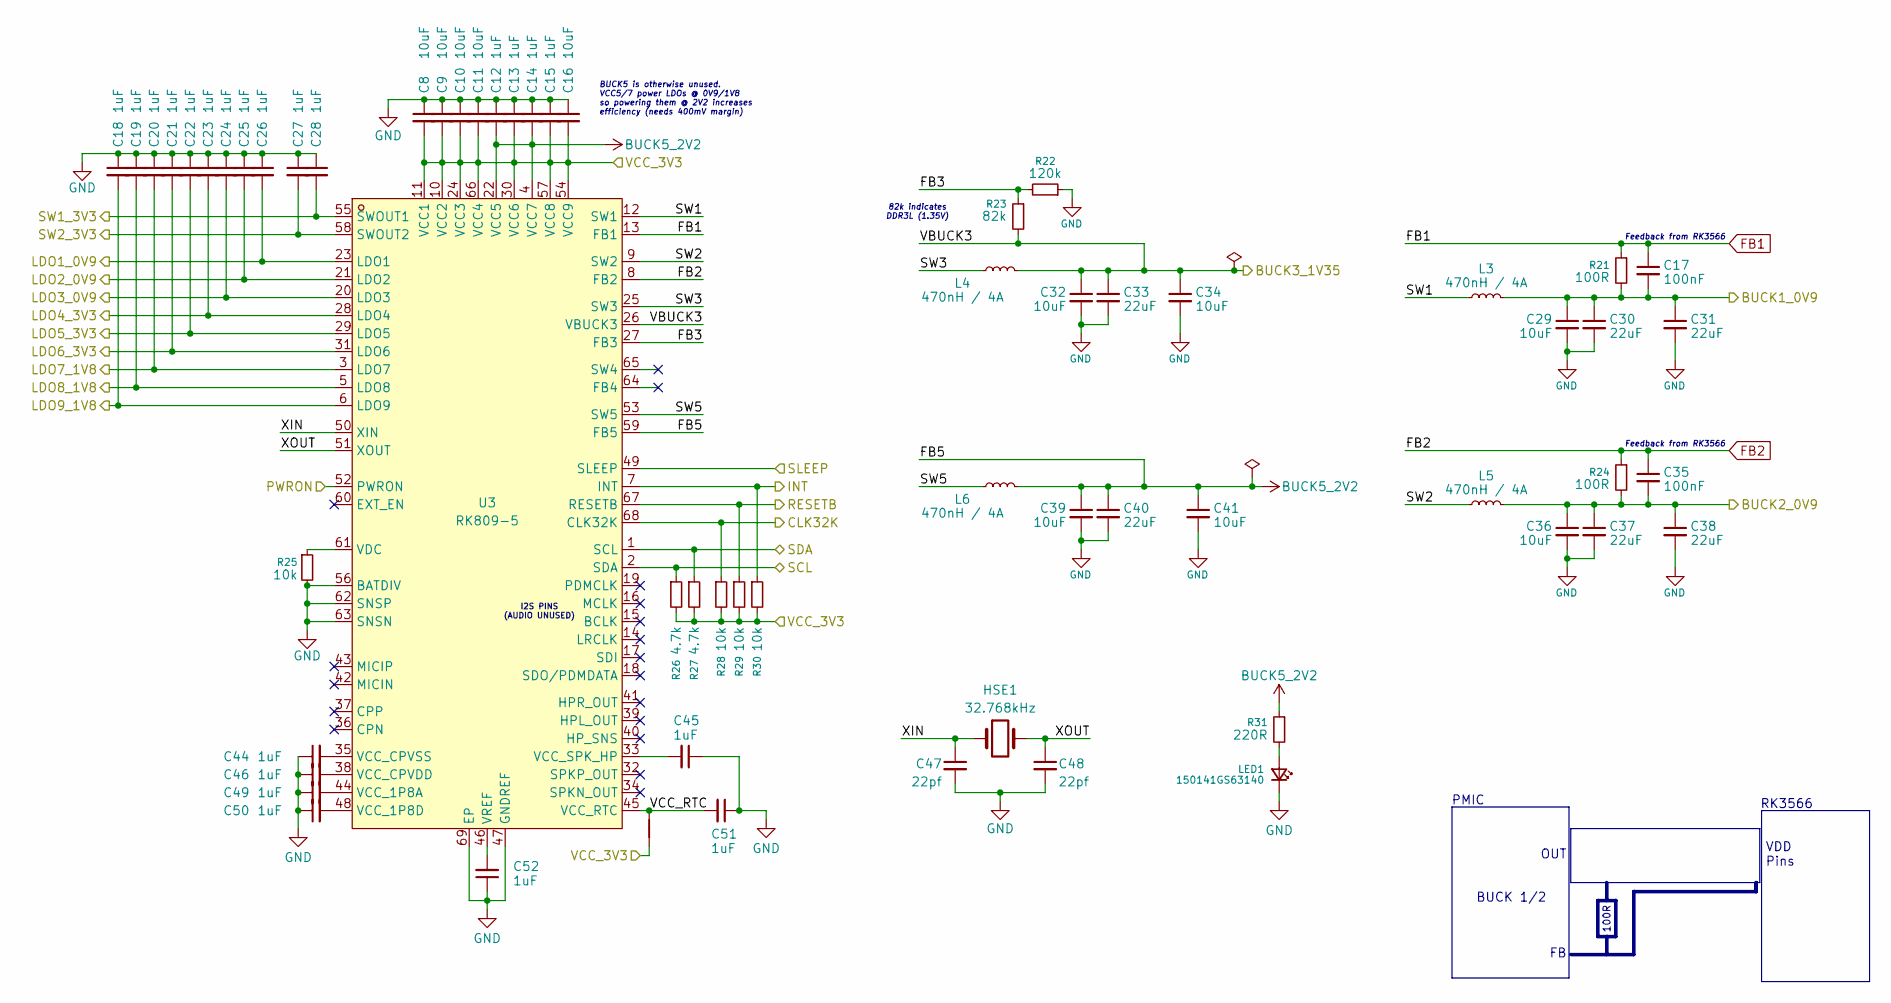
[picture p29: schematic pmic.kicad_sch, Power Management IC]

Parts:
C8, C9, C10, C11, C16, C29, C32, C34, C36, C39, C41: 10uF; C_0805_2012Metric; LCSC PART NAME C15850
C12, C13, C14, C15, C18, C19, C20, C21, C22, C23, C24, C25, C26, C27, C28, C44, C45, C46, C49, C50, C51, C52: 1uF; C_0603_1608Metric; LCSC PART NAME C15849
C17, C35: 100nF; C_0402_1005Metric; LCSC PART NAME C1525
C30, C31, C33, C37, C38, C40: 22uF; C_1206_3216Metric; LCSC PART NAME C12891
C47, C48: 22pf; C_0402_1005Metric; LCSC PART NAME C1555
HSE1: 32.768kHz; Crystal_SMD_3215-2Pin_3.2x1.5mm; LCSC PART NAME C32346
L3, L4, L5, L6: 470nH / 4A; L_0805_2012Metric; LCSC PART NAME C89446
LED1: 150141GS63140; LED_0805_2012Metric; LCSC PART NAME C2297
NT2: NetTie_2
R21, R24: 100R; R_0402_1005Metric; LCSC PART NAME C25076
R22: 120k; R_0603_1608Metric; LCSC PART NAME C25808
R23: 82k; R_0603_1608Metric; LCSC PART NAME C23254
R25, R28, R29, R30: 10k; R_0402_1005Metric; LCSC PART NAME C25744
R26, R27: 4.7k; R_0402_1005Metric; LCSC PART NAME C25900
R31: 220R; R_0603_1608Metric; LCSC PART NAME C22962
U3: RK809-5; ArtInChip_QFN-68-1EP_7x7mm_P0.35mm_EP5.49x5.49mm; MANUFACTURER PART RK809-5; JLCPCB PART CLASS Extended Part

Connections:
/PMIC_CLK: R28.1, U3.68 (CLK32K); also elsewhere on the board
/PMIC_INT: R30.1, U3.7 (INT); also elsewhere on the board
/PMIC_PWRON: U3.52 (PWRON); also elsewhere on the board
/PMIC_RESETB: R29.1, U3.67 (RESETB); also elsewhere on the board
/PMIC_SCL: R26.1, U3.2 (SDA); also elsewhere on the board
/PMIC_SDA: R27.1, U3.1 (SCL); also elsewhere on the board
/PMIC_SLEEP: U3.49 (SLEEP); also elsewhere on the board
/RK809-5 PMIC/FB3: R22.2, R23.1, U3.27 (FB3)
/RK809-5 PMIC/SW1: L3.1, U3.12 (SW1)
/RK809-5 PMIC/SW2: L5.1, U3.9 (SW2)
/RK809-5 PMIC/SW3: L4.1, U3.25 (SW3)
/RK809-5 PMIC/SW5: L6.1, U3.53 (SW5)
/RK809-5 PMIC/VCC_RTC: C51.2, NT2.2, U3.45 (VCC_RTC)
/RK809-5 PMIC/XIN: C47.1, HSE1.1, U3.50 (XIN)
/RK809-5 PMIC/XOUT: C48.1, HSE1.2, U3.51 (XOUT)
/RK3566 SoC/VCCA_1V8: C20.2, U3.3 (LDO7); also elsewhere on the board
/RK3566 SoC/VCCA_1V8_IMG: C18.2, U3.6 (LDO9); also elsewhere on the board
/RK3566 SoC/VCCA_1V8_PMU: C19.2, U3.5 (LDO8); also elsewhere on the board
/RK3566 SoC/VCCIO_3V3_SD: C23.2, U3.28 (LDO4); also elsewhere on the board
/RK3566 SoC/VCC_3V3: C28.2, U3.55 (SWOUT1); also elsewhere on the board
/RK3566 SoC/VCC_3V3_PMU: C21.2, U3.31 (LDO6); also elsewhere on the board
/RK3566 SoC/VDDA_0V9: C25.2, U3.21 (LDO2); also elsewhere on the board
/RK3566 SoC/VDDA_0V9_IMG: C26.2, U3.23 (LDO1); also elsewhere on the board
/RK3566 SoC/VDDA_0V9_PMU: C24.2, U3.20 (LDO3); also elsewhere on the board
/RK3566 SoC/VDD_GPU_NPU: C35.2, C36.1, C37.1, C38.1, L5.2, R24.2; also elsewhere on the board
/RK3566 SoC/VDD_LOGIC: C17.2, C29.1, C30.1, C31.1, L3.2, R21.2; also elsewhere on the board
BUCK5_2V2: C12.2, C14.2, C39.1, C40.1, C41.1, L6.2, R31.1, U3.4 (VCC7), U3.22 (VCC5), U3.59 (FB5)
FB1: C17.1, R21.1, U3.13 (FB1)
FB2: C35.1, R24.1, U3.8 (FB2)
GND: C8.1, C9.1, C10.1, C11.1, C12.1, C13.1, C14.1, C15.1, C16.1, C18.1, C19.1, C20.1, C21.1, C22.1, C23.1, C24.1, C25.1, C26.1, C27.1, C28.1, C29.2, C30.2, C31.2, C32.2, C33.2, C34.2, C36.2, C37.2, C38.2, C39.2, C40.2, C41.2, C44.1, C45.1, C46.1, C47.2, C48.2, C49.1, C50.1, C51.1, C52.1, LED1.1 (K), R22.1, R25.2, U3.47 (GNDREF), U3.56 (BATDIV), U3.62 (SNSP), U3.63 (SNSN), U3.69 (EP); also elsewhere on the board
unnamed: LED1.2 (A), R31.2
unnamed: C49.2, U3.44 (VCC_1P8A)
unnamed: C50.2, U3.48 (VCC_1P8D)
unnamed: C46.2, U3.38 (VCC_CPVDD)
unnamed: C44.2, U3.35 (VCC_CPVSS)
unnamed: C45.2, U3.33 (VCC_SPK_HP)
unnamed: R25.1, U3.61 (VDC)
unnamed: C52.2, U3.46 (VREF)
VCCIO_3V3_IMU: C22.2, U3.29 (LDO5); also elsewhere on the board
VCC_3V3_SD: C27.2, U3.58 (SWOUT2); also elsewhere on the board
VCC_3V3_SYS: C8.2, C9.2, C10.2, C11.2, C13.2, C15.2, C16.2, NT2.1, R26.2, R27.2, R28.2, R29.2, R30.2, U3.10 (VCC2), U3.11 (VCC1), U3.24 (VCC3), U3.30 (VCC6), U3.54 (VCC9), U3.57 (VCC8), U3.66 (VCC4); also elsewhere on the board
VCC_DDR: C32.1, C33.1, C34.1, L4.2, R23.2, U3.26 (VBUCK3); also elsewhere on the board

Notes on the sheet:
OUT
100R
PMIC
I2S PINS (AUDIO UNUSED)
82k indicates DDR3L (1.35V)
BUCK5 is otherwise unused. VCC5/7 power LDOs @ 0V9/1V8 so powering them @ 2V2 increases efficiency (needs 400mV margin)
Feedback from RK3566
RK3566
VDD Pins
BUCK 1/2

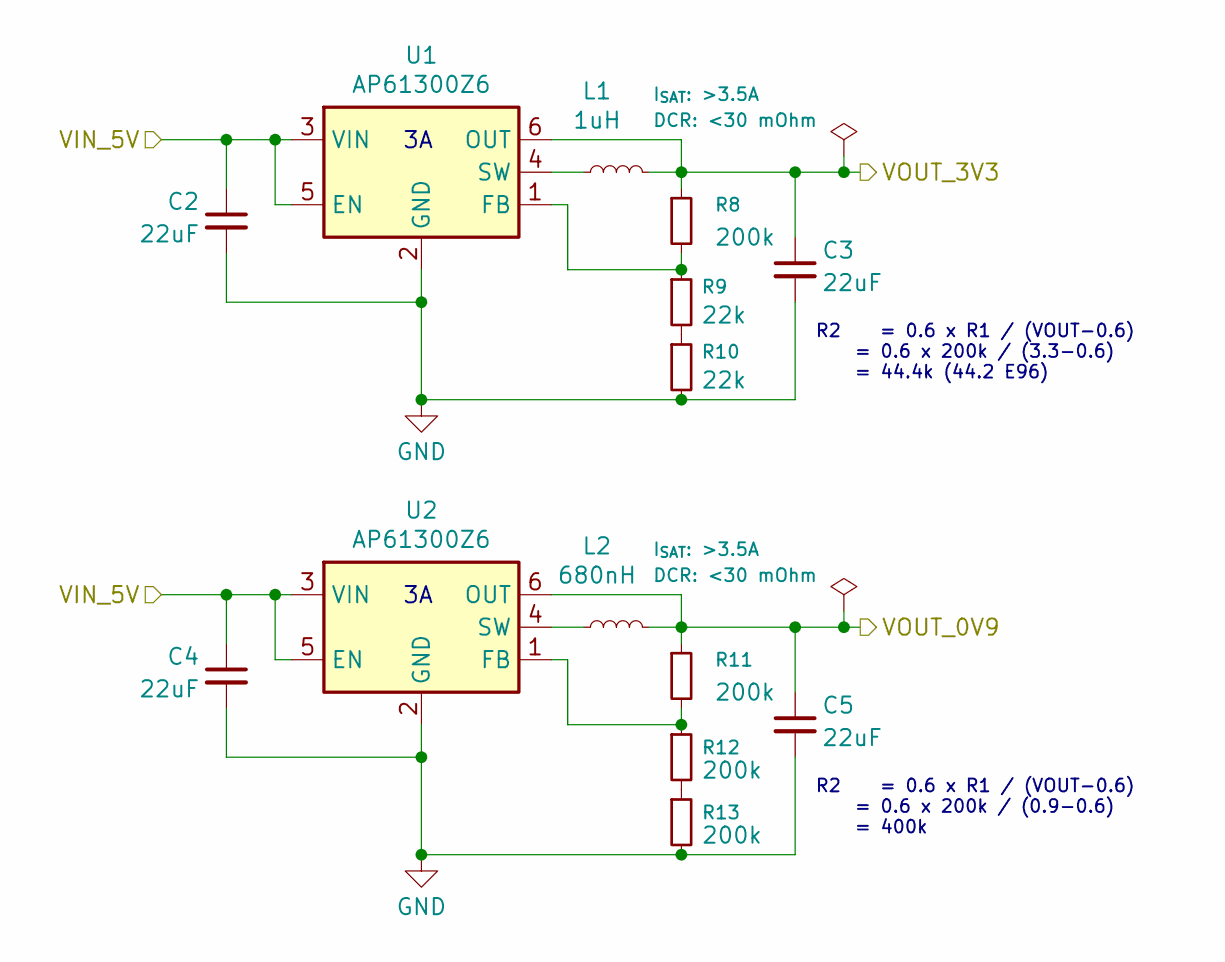
[picture p30: schematic power.kicad_sch, Buck Converters]

Parts:
C2, C3, C4, C5: 22uF; C_1206_3216Metric; LCSC PART NAME C12891
L1: 1uH; L_0805_2012Metric; LCSC PART NAME C1042
L2: 680nH; L_0603_1608Metric; LCSC PART NAME C55546
R8, R11, R12, R13: 200k; R_0402_1005Metric; LCSC PART NAME C25764
R9, R10: 22k; R_0402_1005Metric; LCSC PART NAME C25768
U1, U2: AP61300Z6; SOT-563

Connections:
/Power Supply/VIN_5V: C2.1, C4.1, U1.3 (VIN), U1.5 (EN), U2.3 (VIN), U2.5 (EN); also elsewhere on the board
GND: C2.2, C3.2, C4.2, C5.2, R10.2, R13.2, U1.2 (GND), U2.2 (GND); also elsewhere on the board
unnamed: R9.2, R10.1
unnamed: R12.2, R13.1
unnamed: R8.2, R9.1, U1.1 (FB)
unnamed: L1.1, U1.4 (SW)
unnamed: R11.2, R12.1, U2.1 (FB)
unnamed: L2.1, U2.4 (SW)
VCC_0V9_CPU: C5.1, L2.2, R11.1, U2.6 (OUT); also elsewhere on the board
VCC_3V3_SYS: C3.1, L1.2, R8.1, U1.6 (OUT); also elsewhere on the board

Notes on the sheet:
R2 = 0.6 x R1 / (VOUT-0.6) = 0.6 x 200k / (0.9-0.6) = 400k
R2 = 0.6 x R1 / (VOUT-0.6) = 0.6 x 200k / (3.3-0.6) = 44.4k (44.2 E96)

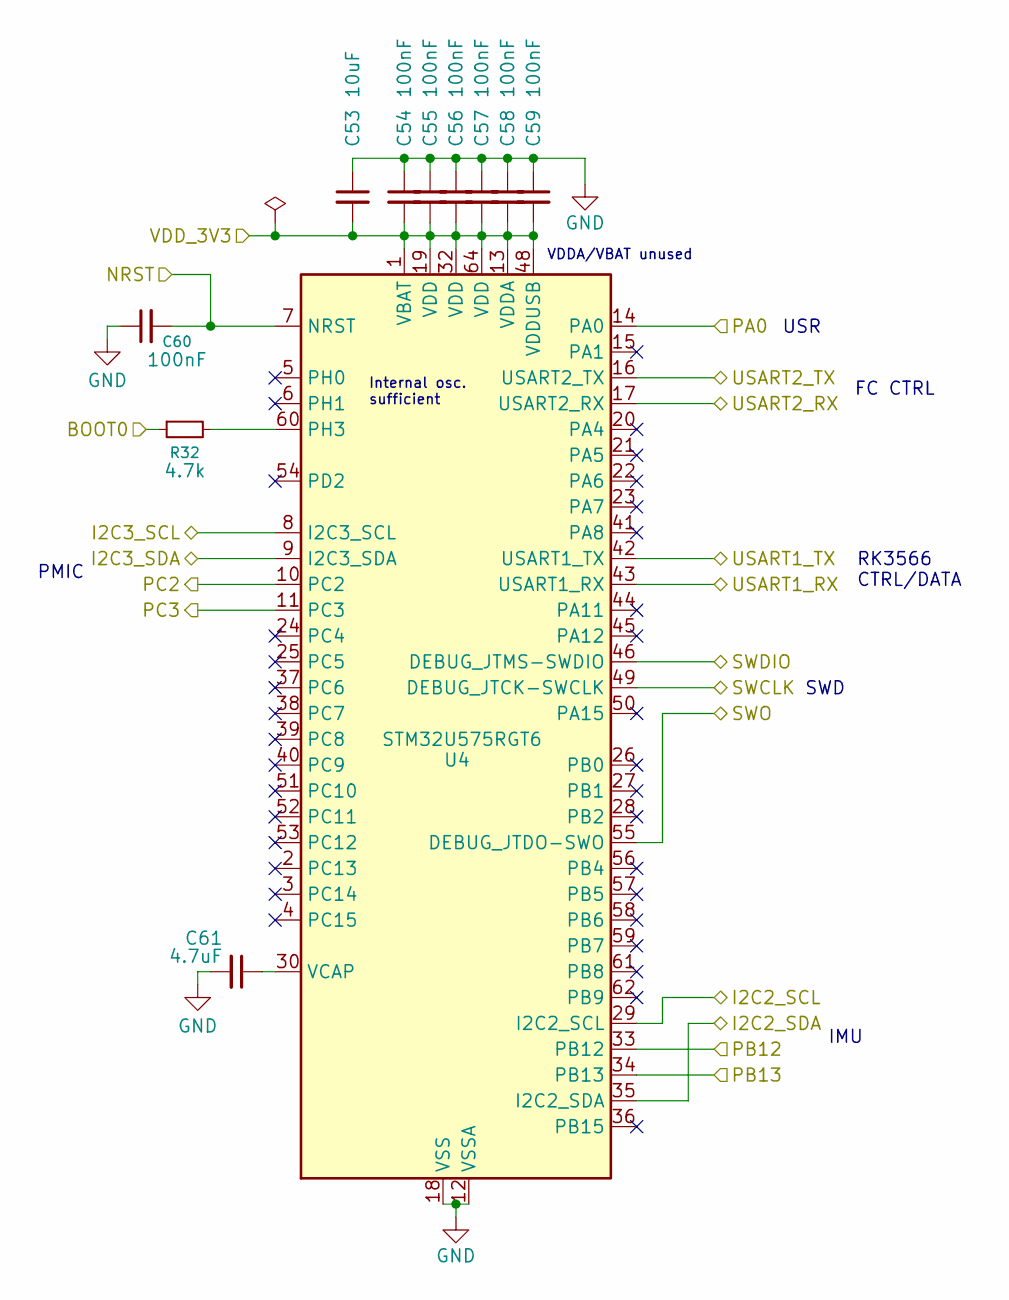
[picture p31: schematic stm32.kicad_sch, STM32U575RGT6 Microcontroller]

Parts:
C53: 10uF; C_0805_2012Metric; LCSC PART NAME C15850
C54, C55, C56, C57, C58, C59, C60: 100nF; C_0402_1005Metric; LCSC PART NAME C1525
C61: 4.7uF; C_0805_2012Metric; LCSC PART NAME C1779
R32: 4.7k; R_0402_1005Metric; LCSC PART NAME C25900
U4: STM32U575RGT6; LQFP-64_10x10mm_P0.5mm

Connections:
/LSM6DSRTR/INT1: U4.33 (PB12); also elsewhere on the board
/LSM6DSRTR/INT2: U4.34 (PB13); also elsewhere on the board
/LSM6DSRTR/SCL: U4.29 (I2C2_SCL); also elsewhere on the board
/LSM6DSRTR/SDA: U4.35 (I2C2_SDA); also elsewhere on the board
/PMIC_INT: U4.11 (PC3); also elsewhere on the board
/PMIC_PWRON: U4.10 (PC2); also elsewhere on the board
/PMIC_SCL: U4.8 (I2C3_SCL); also elsewhere on the board
/PMIC_SDA: U4.9 (I2C3_SDA); also elsewhere on the board
/STM32U575RGT6/BOOT0: R32.1; also elsewhere on the board
/STM32U575RGT6/NRST: C60.2, U4.7 (NRST); also elsewhere on the board
/STM32U575RGT6/PA0: U4.14 (PA0); also elsewhere on the board
/STM32U575RGT6/SWCLK: U4.49 (DEBUG_JTCK-SWCLK); also elsewhere on the board
/STM32U575RGT6/SWDIO: U4.46 (DEBUG_JTMS-SWDIO); also elsewhere on the board
/STM32U575RGT6/SWO: U4.55 (DEBUG_JTDO-SWO); also elsewhere on the board
/STM32U575RGT6/USART2_RX: U4.17 (USART2_RX); also elsewhere on the board
/STM32U575RGT6/USART2_TX: U4.16 (USART2_TX); also elsewhere on the board
/STM32U575RGT6/VDD_3V3: C53.2, C54.2, C55.2, C56.2, C57.2, C58.2, C59.2, U4.1 (VBAT), U4.13 (VDDA), U4.19 (VDD), U4.32 (VDD), U4.48 (VDDUSB), U4.64 (VDD); also elsewhere on the board
/STM_RX/RK_TX: U4.43 (USART1_RX); also elsewhere on the board
/STM_TX/RK_RX: U4.42 (USART1_TX); also elsewhere on the board
GND: C53.1, C54.1, C55.1, C56.1, C57.1, C58.1, C59.1, C60.1, C61.2, U4.12 (VSSA), U4.18 (VSS), U4.31 (VSS), U4.47 (VSS), U4.63 (VSS); also elsewhere on the board
unnamed: R32.2, U4.60 (PH3)
unnamed: C61.1, U4.30 (VCAP)

Notes on the sheet:
IMU
USR
PMIC
VDDA/VBAT unused
Internal osc. sufficient
FC CTRL
RK3566 CTRL/DATA
SWD
