eric-handley/a3-srad-camera-kicad/kicad/srad-camera.kicad_pcb

## KiCad design kicad/srad-camera.kicad_pcb (continued)

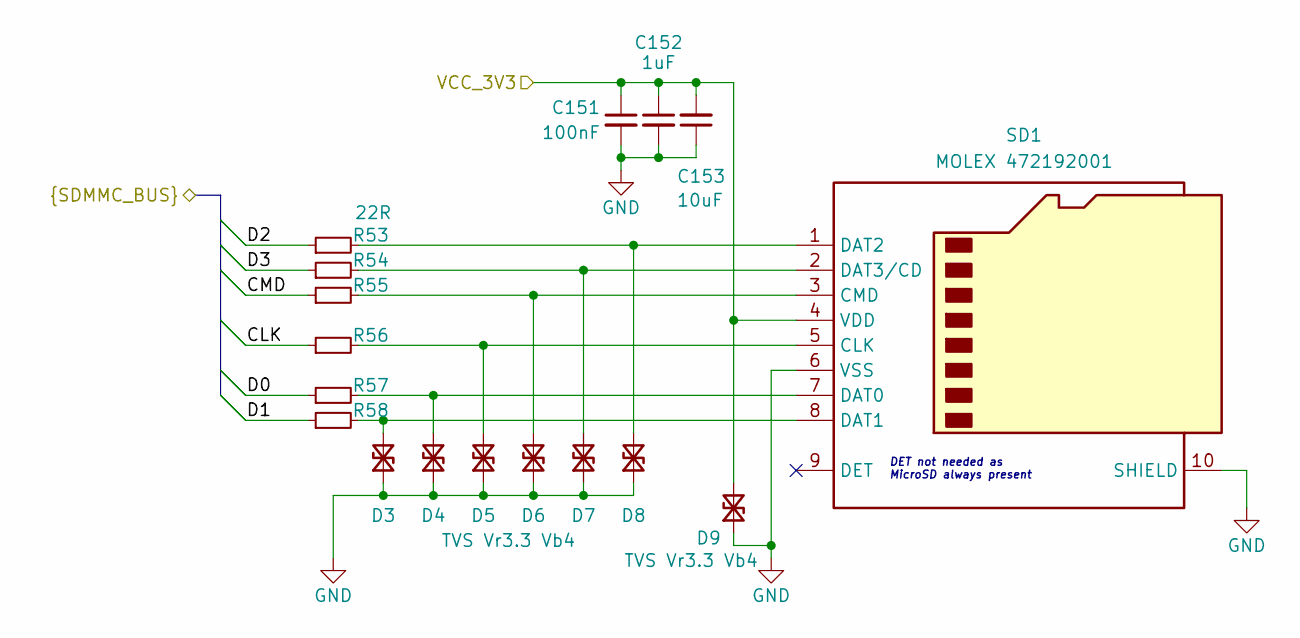
[picture p32: schematic microsd.kicad_sch, MicroSD Card Enclosure]

Parts:
C151: 100nF; C_0402_1005Metric; LCSC PART NAME C1525
C152: 1uF; C_0603_1608Metric; LCSC PART NAME C15849
C153: 10uF; C_0805_2012Metric; LCSC PART NAME C15850
D3, D4, D5, D6, D7, D8, D9: TVS Vr3.3 Vb4; D_SOD-123F; LCSC PART NAME C19077496
R53, R54, R55, R56, R57, R58: 22R; R_0402_1005Metric; LCSC PART NAME C25092
SD1: MOLEX 472192001; microSD_HC_Molex_47219-2001

Connections:
/MicroSD Port/CLK: R56.1; also elsewhere on the board
/MicroSD Port/CMD: R55.1; also elsewhere on the board
/MicroSD Port/D0: R57.1; also elsewhere on the board
/MicroSD Port/D1: R58.1; also elsewhere on the board
/MicroSD Port/D2: R53.1; also elsewhere on the board
/MicroSD Port/D3: R54.1; also elsewhere on the board
GND: C151.2, C152.2, C153.1, D3.1 (A1), D4.1 (A1), D5.1 (A1), D6.1 (A1), D7.1 (A1), D8.1 (A1), D9.1 (A1), SD1.6 (VSS), SD1.10 (SHIELD); also elsewhere on the board
unnamed: D3.2 (A2), R58.2, SD1.8 (DAT1)
unnamed: D4.2 (A2), R57.2, SD1.7 (DAT0)
unnamed: D5.2 (A2), R56.2, SD1.5 (CLK)
unnamed: D6.2 (A2), R55.2, SD1.3 (CMD)
unnamed: D7.2 (A2), R54.2, SD1.2 (DAT3/CD)
unnamed: D8.2 (A2), R53.2, SD1.1 (DAT2)
VCC_3V3_SD: C151.1, C152.1, C153.2, D9.2 (A2), SD1.4 (VDD); also elsewhere on the board

Notes on the sheet:
DET not needed as MicroSD always present

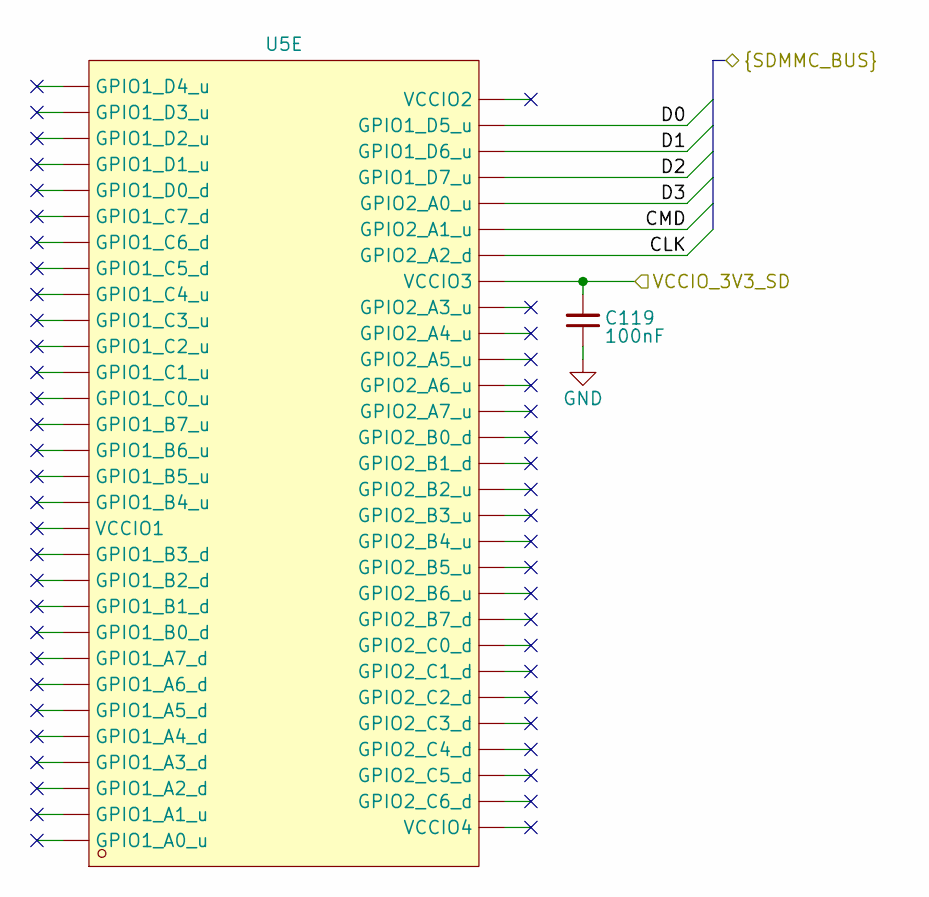
[picture p33: schematic vccio1-4.kicad_sch, VCCIO 1/2/3/4]

Parts:
C119: 100nF; C_0402_1005Metric; LCSC PART NAME C1525
U5: RK3566; BGA-565_L15.5-W14.4-P0.40_RK3566_1; MANUFACTURER PART RK3566; JLCPCB PART CLASS Extended Part

Connections:
/MicroSD Port/CLK: U5.G38 (GPIO2_A2_d); also elsewhere on the board
/MicroSD Port/CMD: U5.1E19 (GPIO2_A1_u); also elsewhere on the board
/MicroSD Port/D0: U5.1E20 (GPIO1_D5_u); also elsewhere on the board
/MicroSD Port/D1: U5.1F19 (GPIO1_D6_u); also elsewhere on the board
/MicroSD Port/D2: U5.1D20 (GPIO1_D7_u); also elsewhere on the board
/MicroSD Port/D3: U5.1F18 (GPIO2_A0_u); also elsewhere on the board
/RK3566 SoC/VCCIO_3V3_SD: C119.2, U5.1F17 (VCCIO3); also elsewhere on the board
GND: C119.1; also elsewhere on the board

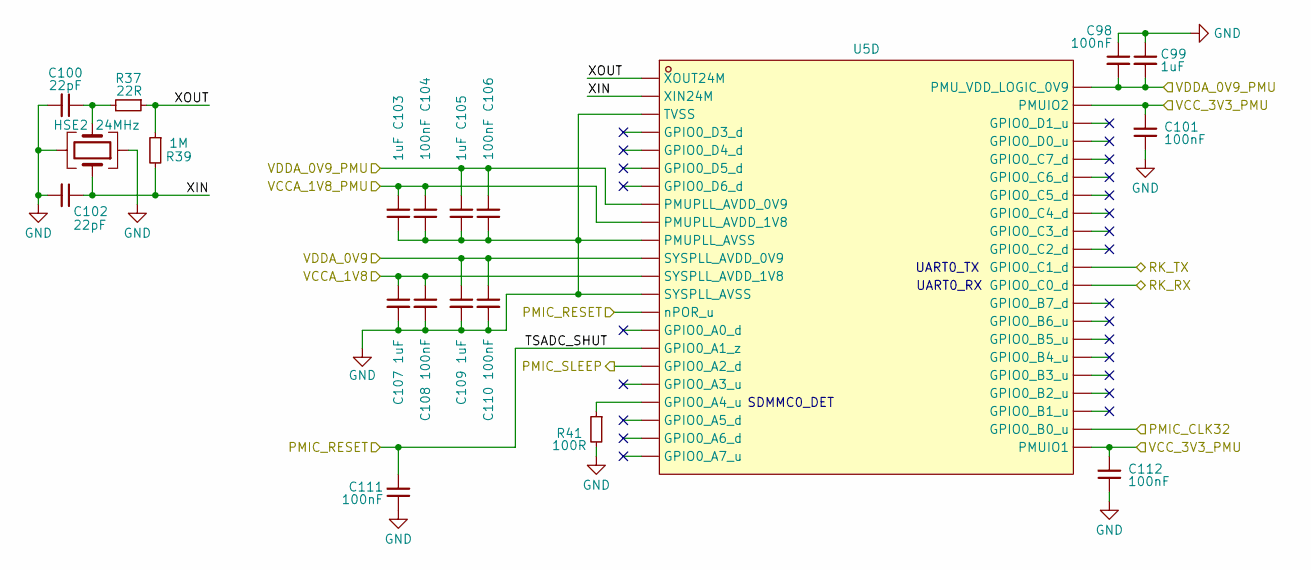
[picture p34: schematic pmuio1-2-osc.kicad_sch, PMUIO 1/2, OSC]

Parts:
C98, C101, C104, C106, C108, C110, C111, C112: 100nF; C_0402_1005Metric; LCSC PART NAME C1525
C99, C103, C105, C107, C109: 1uF; C_0603_1608Metric; LCSC PART NAME C15849
C100, C102: 22pF; C_0402_1005Metric; LCSC PART NAME C1555
HSE2: 24MHz; Crystal_SMD_2016-4Pin_2.0x1.6mm; LCSC PART NAME C725986
R37: 22R; R_0402_1005Metric; LCSC PART NAME C25092
R39: 1M; R_0402_1005Metric; LCSC PART NAME C26083
R41: 100R; R_0402_1005Metric; LCSC PART NAME C25076
U5: RK3566; BGA-565_L15.5-W14.4-P0.40_RK3566_1; MANUFACTURER PART RK3566; JLCPCB PART CLASS Extended Part

Connections:
/PMIC_CLK: U5.1T20 (GPIO0_B0_u); also elsewhere on the board
/PMIC_RESETB: C111.2, U5.1R20 (GPIO0_A1_z), U5.AG38 (nPOR_u); also elsewhere on the board
/PMIC_SLEEP: U5.1P19 (GPIO0_A2_d); also elsewhere on the board
/RK3566 SoC/PMUIO 1-2, OSC/XIN: C102.1, HSE2.1, R39.2, U5.AD37 (XIN24M)
/RK3566 SoC/PMUIO 1-2, OSC/XOUT: R37.1, R39.1, U5.AD38 (XOUT24M)
/RK3566 SoC/VCCA_1V8: C107.1, C108.1, U5.1H4 (SYSPLL_AVDD_1V8); also elsewhere on the board
/RK3566 SoC/VCCA_1V8_PMU: C103.2, C104.2, U5.1N18 (PMUPLL_AVDD_1V8); also elsewhere on the board
/RK3566 SoC/VCC_3V3_PMU: C101.2, C112.2, U5.1N15 (PMUIO2), U5.1P16 (PMUIO1); also elsewhere on the board
/RK3566 SoC/VDDA_0V9: C109.1, C110.1, U5.1H5 (SYSPLL_AVDD_0V9); also elsewhere on the board
/RK3566 SoC/VDDA_0V9_PMU: C98.2, C99.2, C105.2, C106.2, U5.1N16 (PMU_VDD_LOGIC_0V9), U5.1P17 (PMUPLL_AVDD_0V9); also elsewhere on the board
/STM_RX/RK_TX: U5.1R18 (GPIO0_C1_d); also elsewhere on the board
/STM_TX/RK_RX: U5.1T19 (GPIO0_C0_d); also elsewhere on the board
GND: C98.1, C99.1, C100.2, C101.1, C102.2, C103.1, C104.1, C105.1, C106.1, C107.2, C108.2, C109.2, C110.2, C111.1, C112.1, HSE2.2, HSE2.4, R41.2, U5.1J5 (SYSPLL_AVSS), U5.1M18 (TVSS), U5.1N17 (PMUPLL_AVSS); also elsewhere on the board
unnamed: C100.1, HSE2.3, R37.2
unnamed: R41.1, U5.AF37 (GPIO0_A4_u)

Notes on the sheet:
SDMMC0_DET
UART0_TX
UART0_RX

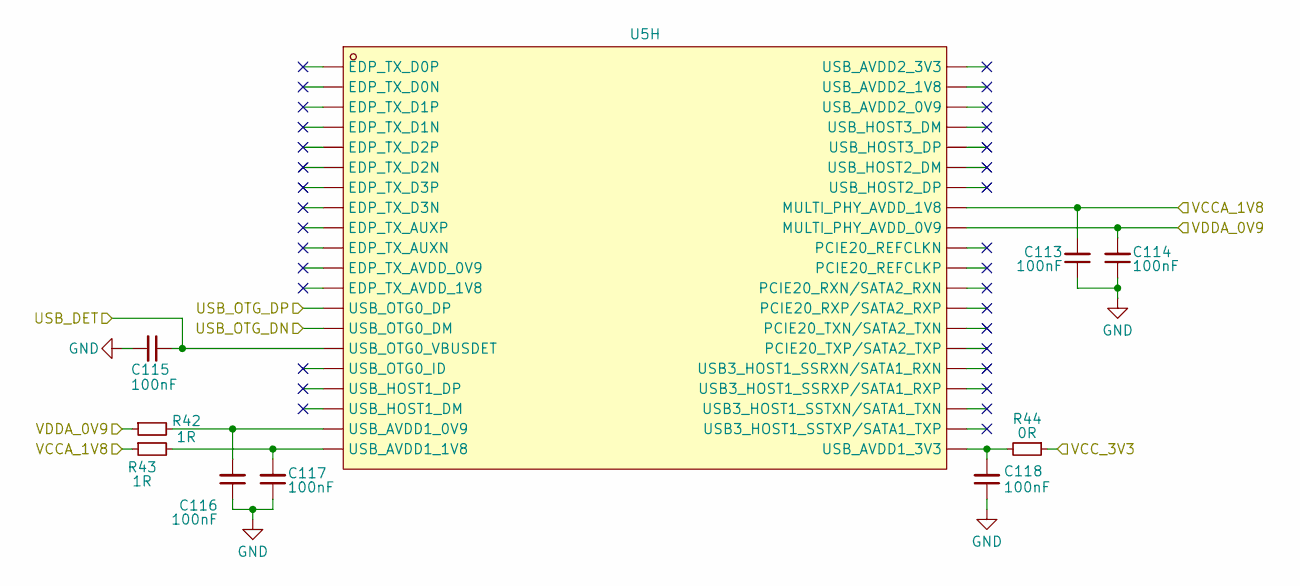
[picture p35: schematic usb-avdd.kicad_sch, USB AVDD]

Parts:
C113, C114, C115, C116, C117, C118: 100nF; C_0402_1005Metric; LCSC PART NAME C1525
R42, R43: 1R; R_0402_1005Metric; LCSC PART NAME C25086
R44: 0R; R_0402_1005Metric; LCSC PART NAME C17168
U5: RK3566; BGA-565_L15.5-W14.4-P0.40_RK3566_1; MANUFACTURER PART RK3566; JLCPCB PART CLASS Extended Part

Connections:
/RK3566 SoC/VCCA_1V8: C113.2, R43.1, U5.1K17 (MULTI_PHY_AVDD_1V8); also elsewhere on the board
/RK3566 SoC/VCC_3V3: R44.1; also elsewhere on the board
/RK3566 SoC/VDDA_0V9: C114.2, R42.1, U5.1K16 (MULTI_PHY_AVDD_0V9); also elsewhere on the board
/USB_DN: U5.R38 (USB_OTG0_DM); also elsewhere on the board
/USB_DP: U5.R37 (USB_OTG0_DP); also elsewhere on the board
/VBUSDET: C115.1, U5.T38 (USB_OTG0_VBUSDET); also elsewhere on the board
GND: C113.1, C114.1, C115.2, C116.1, C117.1, C118.1; also elsewhere on the board
unnamed: C116.2, R42.2, U5.1J17 (USB_AVDD1_0V9)
unnamed: C117.2, R43.2, U5.1H16 (USB_AVDD1_1V8)
unnamed: C118.2, R44.2, U5.1H18 (USB_AVDD1_3V3)

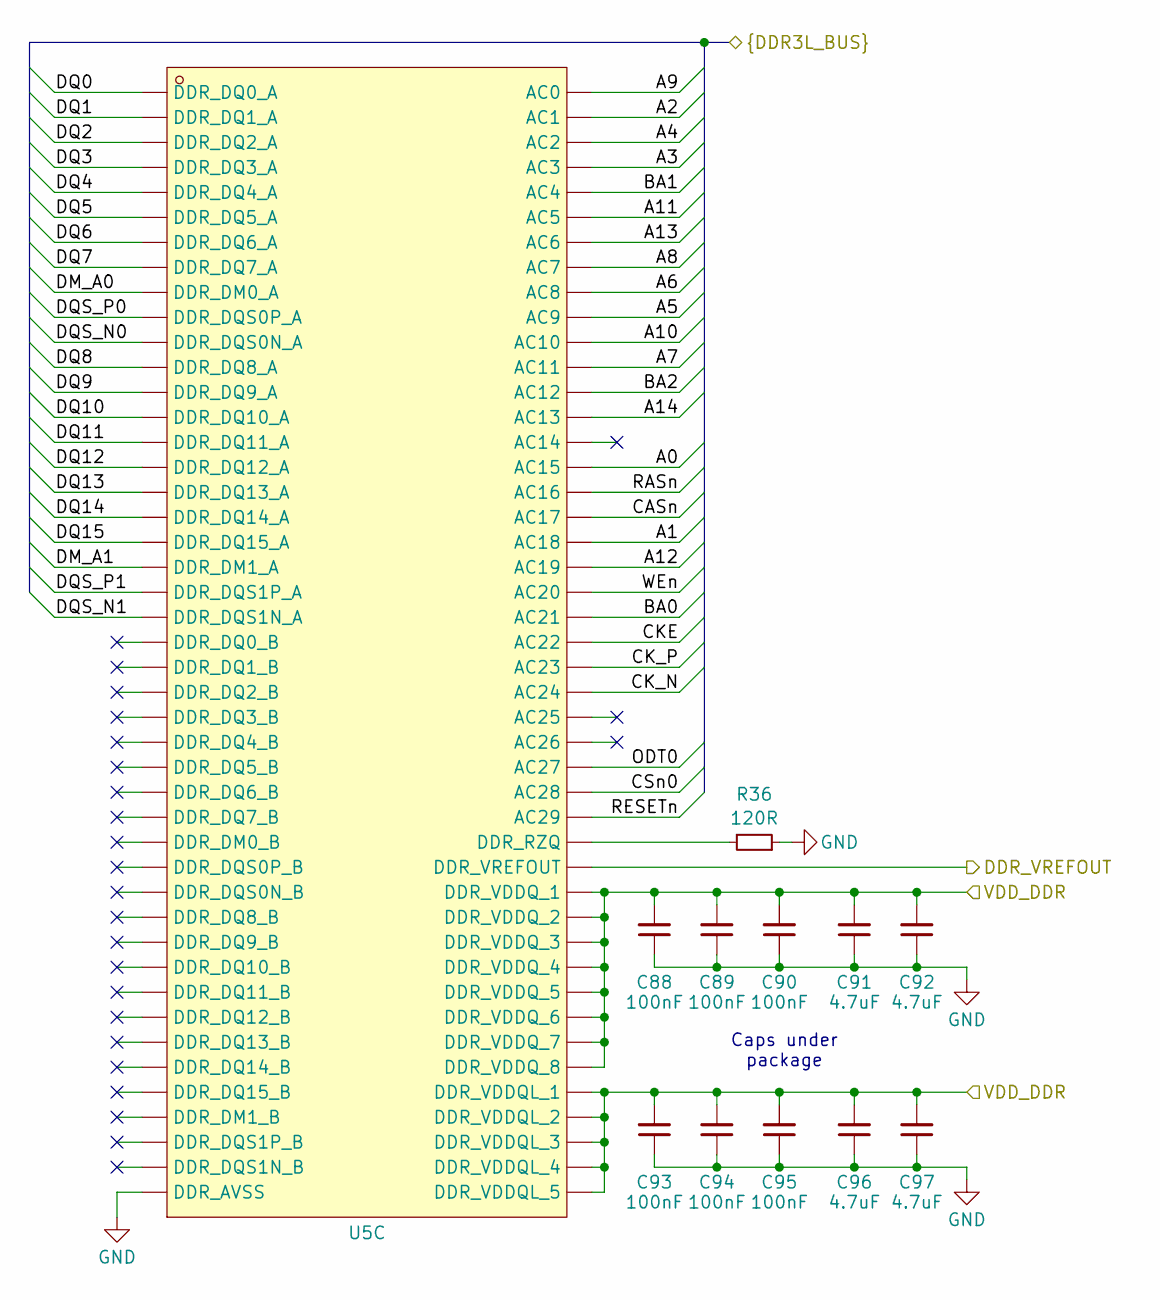
[picture p36: schematic ddr-phy.kicad_sch, DDR PHY]

Parts:
C88, C89, C90, C93, C94, C95: 100nF; C_0402_1005Metric; LCSC PART NAME C1525
C91, C92, C96, C97: 4.7uF; C_0402_1005Metric; LCSC PART NAME C1779
R36: 120R; R_0402_1005Metric; LCSC PART NAME C25079
U5: RK3566; BGA-565_L15.5-W14.4-P0.40_RK3566_1; MANUFACTURER PART RK3566; JLCPCB PART CLASS Extended Part

Connections:
/MT41K256 DDR3L/A0: U5.1C1 (AC15); also elsewhere on the board
/MT41K256 DDR3L/A1: U5.1B7 (AC18); also elsewhere on the board
/MT41K256 DDR3L/A2: U5.1D2 (AC1); also elsewhere on the board
/MT41K256 DDR3L/A3: U5.1C3 (AC3); also elsewhere on the board
/MT41K256 DDR3L/A4: U5.C1 (AC2); also elsewhere on the board
/MT41K256 DDR3L/A5: U5.B7 (AC9); also elsewhere on the board
/MT41K256 DDR3L/A6: U5.E2 (AC8); also elsewhere on the board
/MT41K256 DDR3L/A7: U5.C2 (AC11); also elsewhere on the board
/MT41K256 DDR3L/A8: U5.A10 (AC7); also elsewhere on the board
/MT41K256 DDR3L/A9: U5.A7 (AC0); also elsewhere on the board
/MT41K256 DDR3L/A10: U5.1A3 (AC10); also elsewhere on the board
/MT41K256 DDR3L/A11: U5.B8 (AC5); also elsewhere on the board
/MT41K256 DDR3L/A12: U5.1A6 (AC19); also elsewhere on the board
/MT41K256 DDR3L/A13: U5.B9 (AC6); also elsewhere on the board
/MT41K256 DDR3L/A14: U5.A9 (AC13); also elsewhere on the board
/MT41K256 DDR3L/BA0: U5.1C2 (AC21); also elsewhere on the board
/MT41K256 DDR3L/BA1: U5.1B6 (AC4); also elsewhere on the board
/MT41K256 DDR3L/BA2: U5.1B3 (AC12); also elsewhere on the board
/MT41K256 DDR3L/CASn: U5.1A2 (AC17); also elsewhere on the board
/MT41K256 DDR3L/CKE: U5.B4 (AC22); also elsewhere on the board
/MT41K256 DDR3L/CK_N: U5.B5 (AC24); also elsewhere on the board
/MT41K256 DDR3L/CK_P: U5.A5 (AC23); also elsewhere on the board
/MT41K256 DDR3L/CSn0: U5.1B5 (AC28); also elsewhere on the board
/MT41K256 DDR3L/DM_A0: U5.1E2 (DDR_DM0_A); also elsewhere on the board
/MT41K256 DDR3L/DM_A1: U5.1G1 (DDR_DM1_A); also elsewhere on the board
/MT41K256 DDR3L/DQ0: U5.G2 (DDR_DQ0_A); also elsewhere on the board
/MT41K256 DDR3L/DQ1: U5.F2 (DDR_DQ1_A); also elsewhere on the board
/MT41K256 DDR3L/DQ2: U5.F1 (DDR_DQ2_A); also elsewhere on the board
/MT41K256 DDR3L/DQ3: U5.E1 (DDR_DQ3_A); also elsewhere on the board
/MT41K256 DDR3L/DQ4: U5.M2 (DDR_DQ4_A); also elsewhere on the board
/MT41K256 DDR3L/DQ5: U5.K1 (DDR_DQ5_A); also elsewhere on the board
/MT41K256 DDR3L/DQ6: U5.K2 (DDR_DQ6_A); also elsewhere on the board
/MT41K256 DDR3L/DQ7: U5.1E1 (DDR_DQ7_A); also elsewhere on the board
/MT41K256 DDR3L/DQ8: U5.P2 (DDR_DQ8_A); also elsewhere on the board
/MT41K256 DDR3L/DQ9: U5.R1 (DDR_DQ9_A); also elsewhere on the board
/MT41K256 DDR3L/DQ10: U5.R2 (DDR_DQ10_A); also elsewhere on the board
/MT41K256 DDR3L/DQ11: U5.T2 (DDR_DQ11_A); also elsewhere on the board
/MT41K256 DDR3L/DQ12: U5.M1 (DDR_DQ12_A); also elsewhere on the board
/MT41K256 DDR3L/DQ13: U5.1F2 (DDR_DQ13_A); also elsewhere on the board
/MT41K256 DDR3L/DQ14: U5.1F1 (DDR_DQ14_A); also elsewhere on the board
/MT41K256 DDR3L/DQ15: U5.1G2 (DDR_DQ15_A); also elsewhere on the board
/MT41K256 DDR3L/DQS_N0: U5.H1 (DDR_DQS0N_A); also elsewhere on the board
/MT41K256 DDR3L/DQS_N1: U5.N2 (DDR_DQS1N_A); also elsewhere on the board
/MT41K256 DDR3L/DQS_P0: U5.H2 (DDR_DQS0P_A); also elsewhere on the board
/MT41K256 DDR3L/DQS_P1: U5.N1 (DDR_DQS1P_A); also elsewhere on the board
/MT41K256 DDR3L/ODT0: U5.1A5 (AC27); also elsewhere on the board
/MT41K256 DDR3L/RASn: U5.1A1 (AC16); also elsewhere on the board
/MT41K256 DDR3L/RESETn: U5.1C7 (AC29); also elsewhere on the board
/MT41K256 DDR3L/VREF_DDR: U5.1H3 (DDR_VREFOUT); also elsewhere on the board
/MT41K256 DDR3L/WEn: U5.1A4 (AC20); also elsewhere on the board
GND: C88.1, C89.1, C90.1, C91.1, C92.1, C93.1, C94.1, C95.1, C96.1, C97.1, R36.1, U5.1D4 (DDR_AVSS); also elsewhere on the board
unnamed: R36.2, U5.1F3 (DDR_RZQ)
VCC_DDR: C88.2, C89.2, C90.2, C91.2, C92.2, C93.2, C94.2, C95.2, C96.2, C97.2, U5.1D5 (DDR_VDDQ_1), U5.1D6 (DDR_VDDQ_2), U5.1D7 (DDR_VDDQ_3), U5.1D8 (DDR_VDDQ_4), U5.1D9 (DDR_VDDQ_5), U5.1E4 (DDR_VDDQ_6), U5.1E6 (DDR_VDDQL_1), U5.1E7 (DDR_VDDQL_2), U5.1E9 (DDR_VDDQL_3), U5.1F4 (DDR_VDDQ_7), U5.1F5 (DDR_VDDQL_4), U5.1G4 (DDR_VDDQ_8), U5.1G5 (DDR_VDDQL_5); also elsewhere on the board

Notes on the sheet:
Caps under package

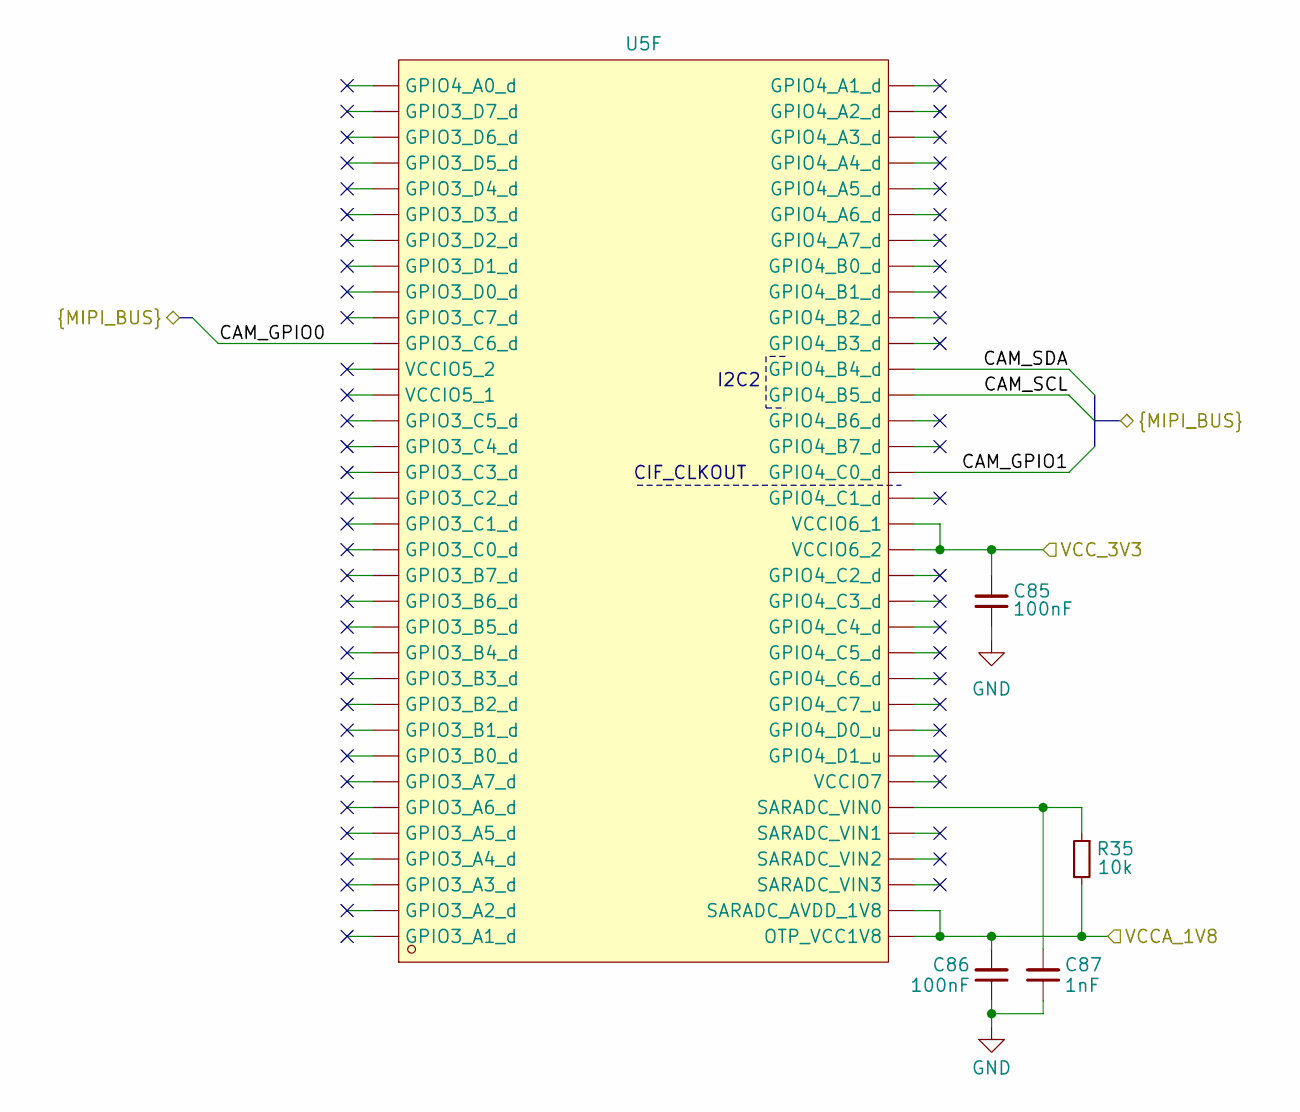
[picture p37: schematic vccio5-7.kicad_sch, VCCIO 5/6/7]

Parts:
C85, C86: 100nF; C_0402_1005Metric; LCSC PART NAME C1525
C87: 1nF; C_0402_1005Metric; LCSC PART NAME C1523
R35: 10k; R_0402_1005Metric; LCSC PART NAME C25744
U5: RK3566; BGA-565_L15.5-W14.4-P0.40_RK3566_1; MANUFACTURER PART RK3566; JLCPCB PART CLASS Extended Part

Connections:
/RK3566 SoC/CAM_GPIO0: U5.1T2 (GPIO3_C6_d); also elsewhere on the board
/RK3566 SoC/CAM_GPIO1: U5.AB2 (GPIO4_C0_d); also elsewhere on the board
/RK3566 SoC/CAM_SCL: U5.AD1 (GPIO4_B5_d); also elsewhere on the board
/RK3566 SoC/CAM_SDA: U5.AF1 (GPIO4_B4_d); also elsewhere on the board
/RK3566 SoC/VCCA_1V8: C86.2, R35.2, U5.1D15 (OTP_VCC1V8), U5.1D16 (SARADC_AVDD_1V8); also elsewhere on the board
/RK3566 SoC/VCC_3V3: C85.2, U5.1L4 (VCCIO6_1), U5.1L5 (VCCIO6_2); also elsewhere on the board
GND: C85.1, C86.1, C87.1; also elsewhere on the board
unnamed: C87.2, R35.1, U5.1D17 (SARADC_VIN0)

Notes on the sheet:
I2C2
CIF_CLKOUT

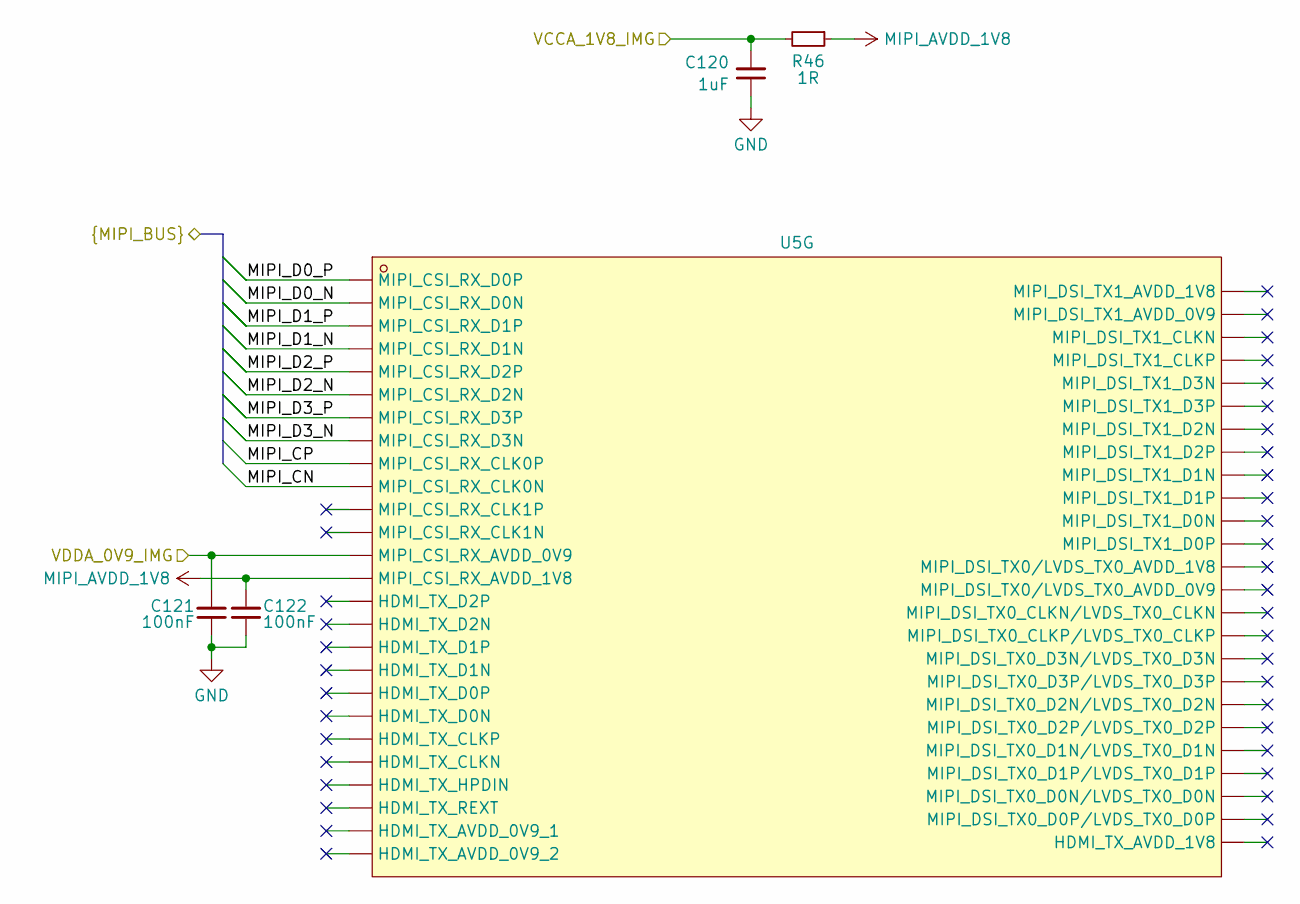
[picture p38: schematic mipi-csi-dsi-hdmi.kicad_sch, MIPI CSI/DSI, HDMI]

Parts:
C120: 1uF; C_0603_1608Metric; LCSC PART NAME C15849
C121, C122: 100nF; C_0402_1005Metric; LCSC PART NAME C1525
R46: 1R; R_0402_1005Metric; LCSC PART NAME C25086
U5: RK3566; BGA-565_L15.5-W14.4-P0.40_RK3566_1; MANUFACTURER PART RK3566; JLCPCB PART CLASS Extended Part

Connections:
/RK3566 SoC/MIPI_CN: U5.1U9 (MIPI_CSI_RX_CLK0N); also elsewhere on the board
/RK3566 SoC/MIPI_CP: U5.1V9 (MIPI_CSI_RX_CLK0P); also elsewhere on the board
/RK3566 SoC/MIPI_D0_N: U5.AR18 (MIPI_CSI_RX_D0N); also elsewhere on the board
/RK3566 SoC/MIPI_D0_P: U5.AP18 (MIPI_CSI_RX_D0P); also elsewhere on the board
/RK3566 SoC/MIPI_D1_N: U5.AP17 (MIPI_CSI_RX_D1N); also elsewhere on the board
/RK3566 SoC/MIPI_D1_P: U5.AR17 (MIPI_CSI_RX_D1P); also elsewhere on the board
/RK3566 SoC/MIPI_D2_N: U5.AR15 (MIPI_CSI_RX_D2N); also elsewhere on the board
/RK3566 SoC/MIPI_D2_P: U5.AP15 (MIPI_CSI_RX_D2P); also elsewhere on the board
/RK3566 SoC/MIPI_D3_N: U5.AP14 (MIPI_CSI_RX_D3N); also elsewhere on the board
/RK3566 SoC/MIPI_D3_P: U5.AR14 (MIPI_CSI_RX_D3P); also elsewhere on the board
/RK3566 SoC/VCCA_1V8_IMG: C120.2, R46.2; also elsewhere on the board
/RK3566 SoC/VDDA_0V9_IMG: C121.2, U5.1N9 (MIPI_CSI_RX_AVDD_0V9); also elsewhere on the board
GND: C120.1, C121.1, C122.1; also elsewhere on the board
MIPI_AVDD_1V8: C122.2, R46.1, U5.1P9 (MIPI_CSI_RX_AVDD_1V8)

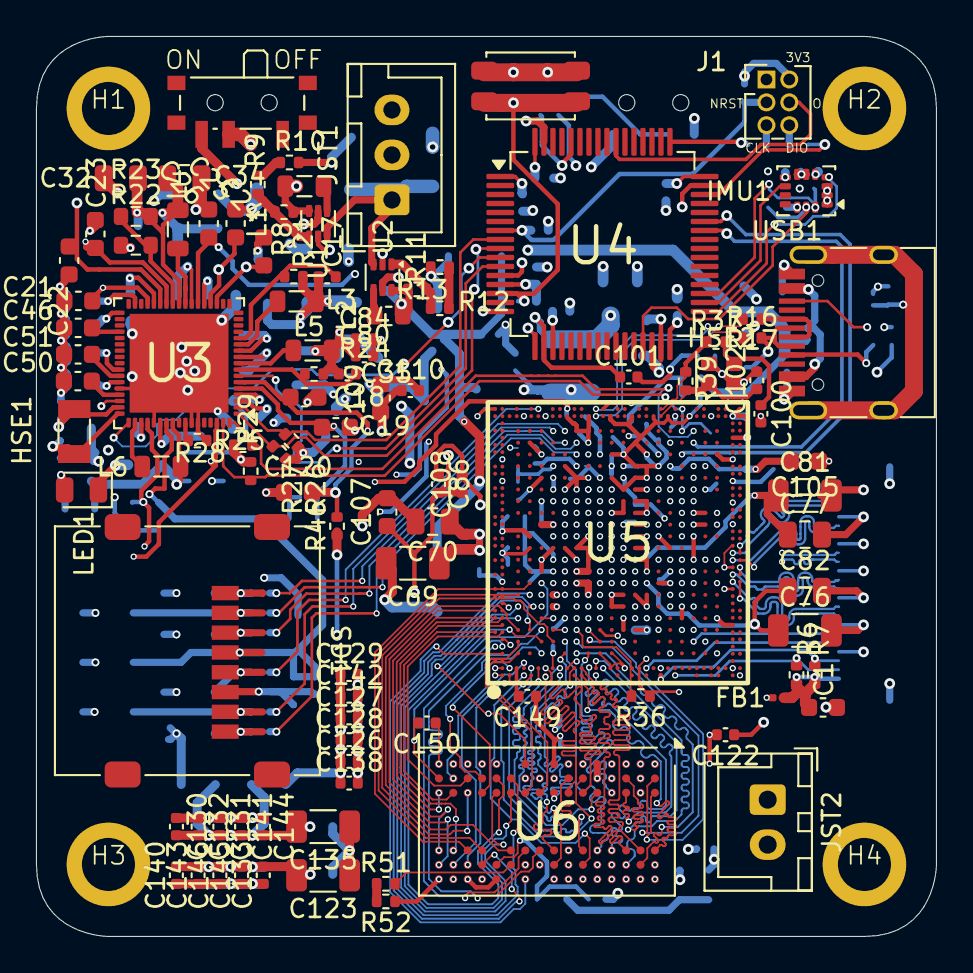
[picture p39: board srad-camera.kicad_pcb from above]

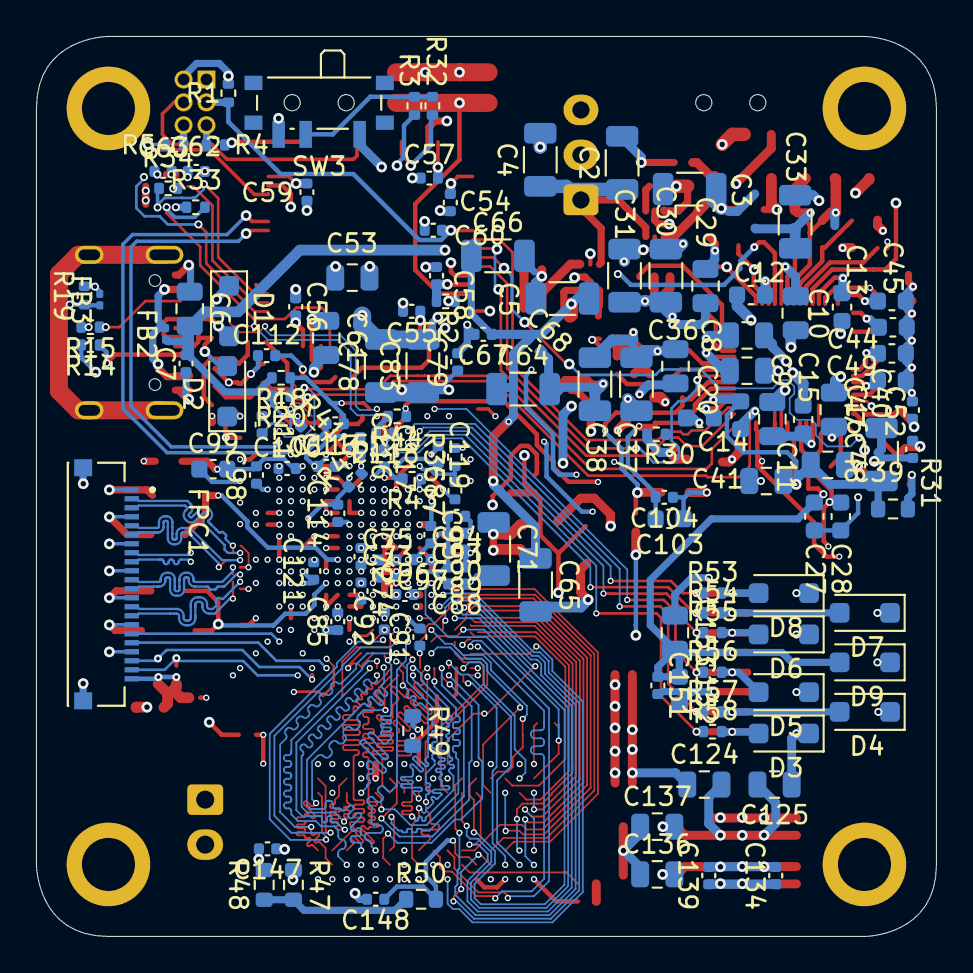
[picture p40: board srad-camera.kicad_pcb from below]

Board: 4 copper layers, 50.0 x 50.0 mm, 247 parts (139 on the bottom side), 170 nets.
