eric-handley/a3-srad-camera-kicad/(commit log)

2025-10-09 STM32 datasheet
2025-10-09 Initial kicad schematic
    [srad-camera.kicad_pcb, srad-camera.kicad_sch, untitled.kicad_sch]
2025-10-09 Add schematics
    [STM32F4_REV2.kicad_sch]
2025-10-09 Fix schematic
    [srad-camera.kicad_sch]
2025-10-25 Wired IMU and USBC, add schematics for RK3566
    [srad-camera.kicad_sch]
2025-10-30 Rm old files
    [untitled.kicad_sch]
2025-10-30 Split schematic to subsheets; wire PMIC, IMU & USB OTG
    [STM32F4_REV2.kicad_sch, ddr3l.kicad_sch, imu.kicad_sch, microsd.kicad_sch, pmic.kicad_sch, rk-soc.kicad_sch, srad-camera.kicad_sch, stm32.kicad_sch]
2025-10-30 Switch to 22pin FPC conn
    [srad-camera.kicad_sch]
2025-10-30 Clean up root wiring
    [pmic.kicad_sch, srad-camera.kicad_sch]
2025-10-30 Clean up IMU wiring
    [imu.kicad_sch]
2025-10-30 Resize sheets
    [ddr3l.kicad_sch, microsd.kicad_sch, rk-soc.kicad_sch, usbc.kicad_sch]
2025-10-30 Draft routing/layout for RK
    [srad-camera.kicad_sch]
2025-10-30 Wire peripherals to STM
    [imu.kicad_sch, pmic.kicad_sch, stm32.kicad_sch]
2025-10-30 Wire microsd port
    [microsd.kicad_sch, rk-soc.kicad_sch, srad-camera.kicad_sch, stm32.kicad_sch]
2025-10-30 Add ports for FC and RK3566
    [pmic.kicad_sch, stm32.kicad_sch]
2025-10-30 Minor changes
    [imu.kicad_sch, usbc.kicad_sch]
2025-10-31 Clean up root sheet, add power supply subsheet
    [ddr3l.kicad_sch, microsd.kicad_sch, pmic.kicad_sch, power.kicad_sch, srad-camera.kicad_sch, stm32.kicad_sch, usbc.kicad_sch]
2025-10-31 Camera datasheet
2025-10-31 Adjust root sheet
    [microsd.kicad_sch, pmic.kicad_sch, rk-soc.kicad_sch, srad-camera.kicad_sch]
2025-10-31 Update buck converters
    [power.kicad_sch, srad-camera.kicad_sch]
2025-10-31 Add power supply and ll shifter
    [ll-shifter.kicad_sch, power.kicad_sch, srad-camera.kicad_sch, usbc.kicad_sch]
2025-10-31 Make sure logic levels are correct between ICs
    [imu.kicad_sch, microsd.kicad_sch, pmic.kicad_sch, rk-soc.kicad_sch, stm32.kicad_sch]
2025-10-31 Datasheet for input buck converter
2025-10-31 Add camera product brief
2025-10-31 Remove uneeded level shifter
    [ll-shifter.kicad_sch, power.kicad_sch, srad-camera.kicad_sch]
2025-10-31 Remove SPI between STM and SoC
2025-11-04 Clean up debug connector, STM pinout
    [srad-camera.kicad_sch, stm32.kicad_sch]
2025-11-04 Reconfigure STM32 pinout to work better with physical pin locations
    [srad-camera.kicad_sch, stm32.kicad_sch]
2025-11-04 Added boot + power switch to STM32, user button
    [srad-camera.kicad_sch, stm32.kicad_sch]
2025-11-14 Finalized PMIC and added control from STM32
    [pmic.kicad_sch, srad-camera.kicad_sch, stm32.kicad_sch]
2025-11-22 Wire up DDR3L
    [ddr3l.kicad_sch, rk-soc.kicad_sch]
2025-11-22 Annotations + minor tweaks
    [imu.kicad_sch, microsd.kicad_sch, pmic.kicad_sch, power.kicad_sch, srad-camera.kicad_sch, stm32.kicad_sch, usbc.kicad_sch]
2025-11-23 Finished wiring RK3566, DDR3L
    [ddr3l.kicad_sch, rk-soc.kicad_sch, srad-camera.kicad_sch]
2025-11-23 Change all sheets to A4, name sheets, split RK3566 into hierarchy
    [ddr-phy.kicad_sch, ddr3l.kicad_sch, imu.kicad_sch, microsd.kicad_sch, mipi-csi-dsi-hdmi.kicad_sch, pmic.kicad_sch, pmuio1-2-osc.kicad_sch, power.kicad_sch]
2025-11-23 Mark as R1.0
    [ddr-phy.kicad_sch, ddr3l.kicad_sch, imu.kicad_sch, microsd.kicad_sch, mipi-csi-dsi-hdmi.kicad_sch, pmic.kicad_sch, pmuio1-2-osc.kicad_sch, power.kicad_sch]
2025-11-24 Indicate proper feedback trace from SoC
    [pmic.kicad_sch, rk-soc.kicad_sch]
2025-11-24 Swap for standard library symbol
    [microsd.kicad_sch]
2025-11-24 Minor tweaks + annotations
    [ddr3l.kicad_sch, imu.kicad_sch, mipi-csi-dsi-hdmi.kicad_sch, pmuio1-2-osc.kicad_sch, rk-soc.kicad_sch]
2025-11-25 Start on PCB design
    [ddr-phy.kicad_sch, ddr3l.kicad_sch, imu.kicad_sch, microsd.kicad_sch, mipi-csi-dsi-hdmi.kicad_sch, pmic.kicad_sch, pmuio1-2-osc.kicad_sch, power.kicad_sch]
2025-11-26 Minor tweaks
    [pmic.kicad_sch, rk-soc.kicad_sch]
2025-11-26 Finished wiring PMIC, STM, power input, IMU, FPC
    [srad-camera.kicad_pcb]
2025-12-02 Remove power/decoupling for unused power domains
    [ddr-phy.kicad_sch, ddr3l.kicad_sch, imu.kicad_sch, microsd.kicad_sch, mipi-csi-dsi-hdmi.kicad_sch, pmic.kicad_sch, pmuio1-2-osc.kicad_sch, power.kicad_sch]
2025-12-02 WIP PCB layout
    [srad-camera.kicad_pcb, srad-camera.kicad_sch]
2026-01-13 All major components placed on board
    [camera.step, ddr-phy.kicad_sch, ddr3l.kicad_sch, pmic.kicad_sch, rk-soc.kicad_sch, srad-camera.csv, srad-camera.kicad_pcb, srad-camera.kicad_sch]
2026-01-14 Allllmost everything placed
    [pmic.kicad_sch, srad-camera.kicad_sch]
2026-01-15 PCB done besides fixing screwups + length matching
    [0472192001.stp, 10051922-2210ELF--3DModel-STEP-533217.STEP, 10051922-2210ELF.step, 12402012E212A--3DModel-STEP-533217.STEP, MT41K256M16TW-107-P--3DModel-STEP-56544.STEP, RK3566--3DModel-STEP-56544.STEP, pmuio1-2-osc.kicad_sch, srad-camera.kicad_sch]
2026-01-15 Minor layout tweaks
    [srad-camera.kicad_pcb]
2026-01-15 More minor layout tweaks
    [srad-camera.kicad_pcb]
2026-01-15 Length matching for DDL3 LDQS
    [srad-camera.kicad_pcb]
2026-01-16 Length matching for DDL3 UDQS
    [srad-camera.kicad_sch]
2026-01-16 Fix length matching for MIPI
    [srad-camera.kicad_pcb]
2026-01-18 Restructure repo
    [srad-camera.kicad_pcb, srad-camera.kicad_sch]
